hexadecim/home-voice-hub/fab/HVH-1_top_render.png

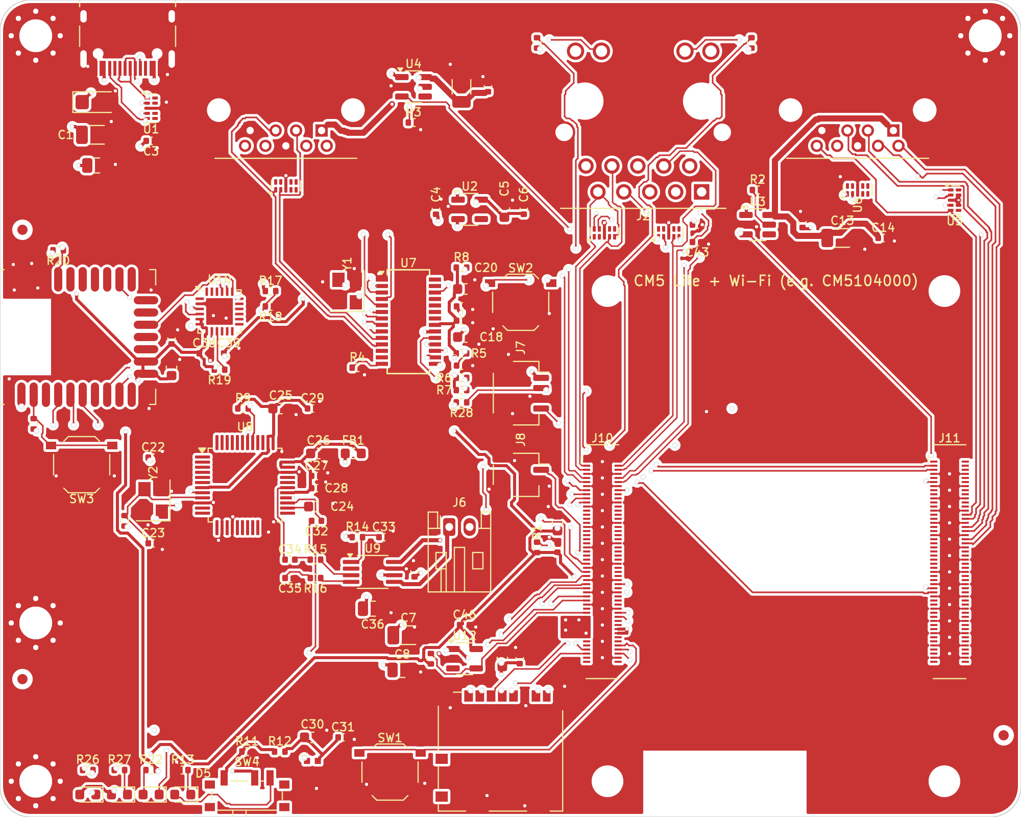
fab/HVH-1_top_render.png
