hexadecim/home-voice-hub/fab/HVH-1_BOM_full.csv

Qty | Designators | Value | Description | Manufacturer | MPN | LCSC | JLC type | LCSC stock (snapshot) | Unit price USD (LCSC, qty 1 tier) | Alternate source | Assembly | Note
1 | J1 | USB-C PWR | USB-C receptacle 16P | Korean Hroparts | TYPE-C-31-M-12 | C165948 | Extended | 367975 | 0.1872 |  | JLC SMT/THT
1 | D1 | SMF5.0A | TVS 5V unidirectional 200W SOD-123FL | LGE/various | SMF5.0A | C193402 | Extended | 557563 | 0.0305 |  | JLC SMT/THT
4 | C1 C7 C13 C15 | 47uF | Cap 47uF 6.3V X5R 1206 | Samsung | CL31A476MQHNNNE | C68361 | Extended | 803090 | 0.1655 |  | JLC SMT/THT
1 | C2 | 22uF | Cap 22uF 25V X5R 0805 | Samsung | CL21A226MAQNNNE | C45783 | Basic | 3360923 | 0.2384 |  | JLC SMT/THT
17 | C3 C6 C11 C14 C16 C19 C21 C27 C28 C29 C31 C37 C39 C41 C42 C43 C45 | 100nF | Cap 100nF 16V X7R 0402 | Samsung | CL05B104KO5NNNC | C1525 | Basic | 22560770 | 0.0043 |  | JLC SMT/THT
6 | U1 U5 U6 U13 U14 U15 | TPD4EUSB30 | 4-ch low-cap ESD (USB3/Ethernet) | Texas Instruments | TPD4EUSB30DQAR | C90627 | Extended | 23515 | 0.3787 |  | JLC SMT/THT
1 | U2 | TLV75533P | LDO 3.3V 500mA | Texas Instruments | TLV75533PDBVR | C404027 | Extended | 116994 | 0.1218 |  | JLC SMT/THT
9 | C4 C12 C17 C32 C33 C34 C35 C38 C46 | 1uF | Cap 1uF 25V X5R 0402 | Samsung | CL05A105KA5NQNC | C52923 | Basic | 7514754 | 0.0081 |  | JLC SMT/THT
5 | C5 C10 C20 C30 C44 | 4.7uF | Cap 4.7uF 16V X5R 0603 | Samsung | CL10A475KO8NNNC | C19666 | Basic | 2948420 | 0.0297 |  | JLC SMT/THT
2 | J10 J11 | DF40C-100DS | CM5 board-to-board receptacle 100P 0.4mm 1.5mm stack | Hirose | DF40C-100DS-0.4V(51) | C597931 | Extended | 29944 | 0.9688 |  | JLC SMT/THT
1 | M1 | CM5 module | Compute Module 5 - plugs into J10/J11 (not soldered) | Raspberry Pi | CM5104000 (CM5 Lite, Wireless, 4GB) |  |  |  |  | Raspberry Pi approved resellers (CM5104000 / CM5102000 / CM5108000) | customer fits CM5 module
1 | R1 | 0R | Resistor 0R 0402 | UNI-ROYAL | 0402WGF0000TCE | C17168 | Basic | 9136350 | 0.0011 |  | JLC SMT/THT
2 | C8 C36 | 10uF | Cap 10uF 25V X5R 0805 | Samsung | CL21A106KAYNNNE | C15850 | Basic | 3710191 | 0.0692 |  | JLC SMT/THT
2 | J3 J4 | USB-A | USB 3.0 Type-A receptacle, R/A THT | Amphenol | GSB311131HR | C473057 | Extended | 15128 | 1.5818 |  | JLC SMT/THT
2 | U3 U4 | TPS2553 | USB power switch, adj. ILIM | Texas Instruments | TPS2553DBVR | C55266 | Extended | 54233 | 0.5426 |  | JLC SMT/THT
2 | R2 R3 | 26k1 1% | Resistor 26.1k 1% 0402 (TPS2553 ILIM ~1.0A) | YAGEO | RC0402FR-0726K1L | C155697 | Extended | 157321 | 0.0018 |  | JLC SMT/THT
1 | U7 | FE1.1s | USB2.0 4-port MTT hub | Terminus | FE1.1S-BSOP28BCN | C9359 | Extended | 27772 | 0.6934 |  | JLC SMT/THT
2 | Y1 Y2 | 12MHz | Crystal 12MHz 20pF 3225 | Yangxing | X322512MSB4SI | C9002 | Basic | 134433 | 0.0956 |  | JLC SMT/THT
1 | R4 | 2k7 1% | Resistor 2.7k 1% 0402 | UNI-ROYAL | 0402WGF2701TCE | C25885 | Extended | 212522 | 0.0023 |  | JLC SMT/THT
11 | R5 R6 R7 R8 R11 R15 R16 R20 R21 R25 R28 | 10k | Resistor 10k 1% 0402 | UNI-ROYAL | 0402WGF1002TCE | C25744 | Basic | 21489602 | 0.0033 |  | JLC SMT/THT
5 | C18 C24 C25 C26 C40 | 10uF | Cap 10uF 10V X5R 0603 | Samsung | CL10A106KP8NNNC | C19702 | Basic | 10061272 | 0.0297 |  | JLC SMT/THT
1 | FB1 | 600R@100MHz | Ferrite bead 600R 200mA 0603 | Sunlord | GZ1608D601TF | C1002 | Basic | 717275 | 0.0116 |  | JLC SMT/THT
1 | U8 | CM108B | USB audio codec (mic in / line out) | C-Media | CM108B | C371347 | Extended | 2907 | 3.5913 |  | JLC SMT/THT
1 | R9 | 1k5 | Resistor 1.5k 1% 0402 | UNI-ROYAL | 0402WGF1501TCE | C25867 | Basic | 1809989 | 0.0029 |  | JLC SMT/THT
1 | R10 | 1M | Resistor 1M 1% 0402 | UNI-ROYAL | 0402WGF1004TCE | C26083 | Basic | 2050671 | 0.0024 |  | JLC SMT/THT
2 | C22 C23 | 27pF | Cap 27pF 50V C0G 0402 | FH | 0402CG270J500NT | C1557 | Preferred | 278621 | 0.0024 |  | JLC SMT/THT
1 | SW4 | PCM12SMTR | SPDT slide switch R/A (mic privacy) | C&K | PCM12SMTR | C221841 | Extended | 10765 | 1.272 |  | JLC SMT/THT
2 | R12 R22 | 100R | Resistor 100R 1% 0402 | UNI-ROYAL | 0402WGF1000TCE | C25076 | Basic | 8287966 | 0.0012 |  | JLC SMT/THT
1 | MK1 | ZTS6216 | Analog MEMS microphone, top port, -38dBV, 65dB SNR | ZILLTEK | ZTS6216 | C481302 | Extended | 25297 | 0.7376 |  | JLC SMT/THT
2 | D2 D5 | Red | LED red 0603 | KENTO | KT-0603R | C2286 | Basic | 7858146 | 0.0077 |  | JLC SMT/THT
3 | R13 R23 R24 | 470R | Resistor 470R 1% 0402 | UNI-ROYAL | 0402WGF4700TCE | C25117 | Basic | 646592 | 0.0027 |  | JLC SMT/THT
1 | U9 | PAM8302A | 2.5W mono class-D amplifier | Diodes Inc | PAM8302AASCR | C113367 | Extended | 13083 | 0.3221 |  | JLC SMT/THT
1 | R14 | 100k | Resistor 100k 1% 0402 | UNI-ROYAL | 0402WGF1003TCE | C25741 | Basic | 9721665 | 0.0015 |  | JLC SMT/THT
1 | J6 | SPEAKER | JST PH 2P R/A (speaker 4-8 ohm, 2W) | JST | S2B-PH-K-S(LF)(SN) | C173752 | Extended | 219392 | 0.0397 |  | JLC SMT/THT
1 | U10 | CP2102N | USB-UART bridge | Silicon Labs | CP2102N-A02-GQFN24R | C969151 | Extended | 15328 | 1.9883 |  | JLC SMT/THT
1 | R17 | 47k | Resistor 47k 1% 0402 | UNI-ROYAL | 0402WGF4702TCE | C25792 | Basic | 5135462 | 0.0026 |  | JLC SMT/THT
1 | R18 | 68k | Resistor 68k 1% 0402 | UNI-ROYAL | 0402WGF6802TCE | C36871 | Preferred | 171056 | 0.002 |  | JLC SMT/THT
3 | R19 R26 R27 | 1k | Resistor 1k 1% 0402 | UNI-ROYAL | 0402WGF1001TCE | C11702 | Basic | 14385321 | 0.0036 |  | JLC SMT/THT
1 | U11 | MGM210PA32JIA2 | Zigbee/Thread module EFR32MG21 +20dBm, chip antenna (same module as HA Yellow) | Silicon Labs | MGM210PA32JIA2 | C1864147 | Extended | 10 | 17.8482 | DigiKey 336-MGM210PA32JIA2-ND / Farnell 3463094 (R variant) | JLC SMT/THT | Low LCSC stock: order via JLC Global Sourcing or consign from DigiKey
1 | D4 | Blue | LED blue 0603 | XINGLIGHT | XL-1608UBC-04 | C965807 | Extended | 1818138 | 0.0043 |  | JLC SMT/THT
3 | SW1 SW2 SW3 | TS-1187A | Tactile switch 5.1x5.1mm SMD | XKB | TS-1187A-B-A-B | C318884 | Basic | 296384 | 0.0207 |  | JLC SMT/THT
13 | TP1 TP2 TP3 TP4 TP5 TP6 TP7 TP8 TP9 TP10 TP11 TP12 TP13 | TP | Test pad |  |  |  |  |  |  |  | not assembled
1 | J2 | RJ45 1G | RJ45 gigabit MagJack with LEDs | HanRun | HR911130A | C54408 | Extended | 21057 | 2.5488 |  | JLC SMT/THT
1 | J5 | microSD | microSD push-pull socket | Molex | 1040310811 | C585350 | Extended | 4106 | 0.8327 |  | JLC SMT/THT
1 | U12 | RT9742GGJ5 | SD card power switch | Richtek | RT9742GGJ5 | C250547 | Extended | 11605 | 0.176 |  | JLC SMT/THT
1 | D3 | Green | LED green 0603 | XINGLIGHT | XL-1608UGC-04 | C965804 | Extended | 2090501 | 0.005 |  | JLC SMT/THT
1 | J7 | FAN | JST SH 4P R/A (Pi fan) | JST | SM04B-SRSS-TB(LF)(SN) | C160404 | Extended | 60891 | 0.2151 |  | JLC SMT/THT
1 | J8 | RTC BAT | JST SH 2P R/A (Pi RTC battery) | JST | SM02B-SRSS-TB(LF)(SN) | C160402 | Extended | 63871 | 0.1327 |  | JLC SMT/THT
4 | H1 H2 H3 H4 | M3 | Mounting hole M3, GND |  |  |  |  |  |  |  | not assembled
3 | FID1 FID2 FID3 | FID | Fiducial |  |  |  |  |  |  |  | not assembled
