hexadecim/home-voice-hub/enclosure/hvh1_enclosure_assembly.step

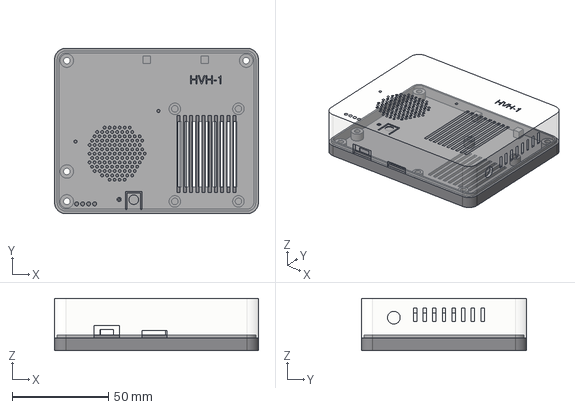
[picture p2: CAD file, 2026-11-11]
enclosure/hvh1_enclosure_assembly.step
105.8 x 85.8 x 27.1 mm
base
lid
