hexadecim/home-voice-hub/fab/HVH-1_pcb.step

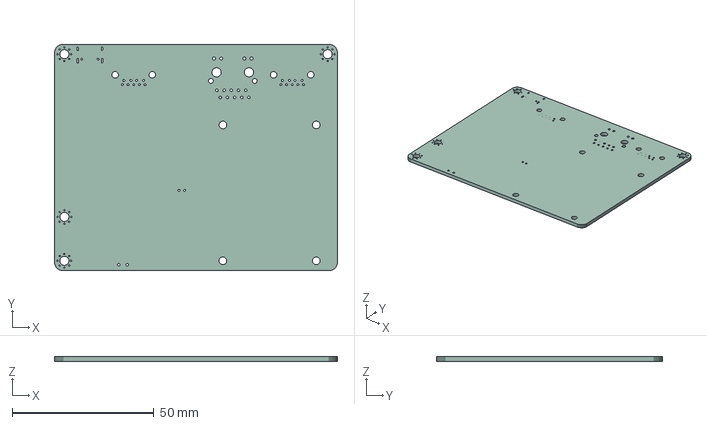
[picture p3: CAD file, 2026-11-11]
fab/HVH-1_pcb.step
100.0 x 80.0 x 1.60 mm
