hexadecim/home-voice-hub/enclosure/hvh1_lid.step

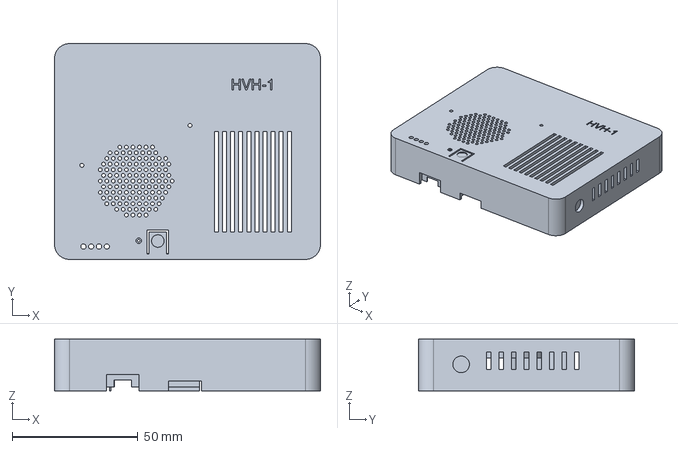
[picture p4: CAD file, 2026-11-11]
enclosure/hvh1_lid.step
105.8 x 85.8 x 20.5 mm
