hexadecim/home-voice-hub/enclosure/hvh1_base.step

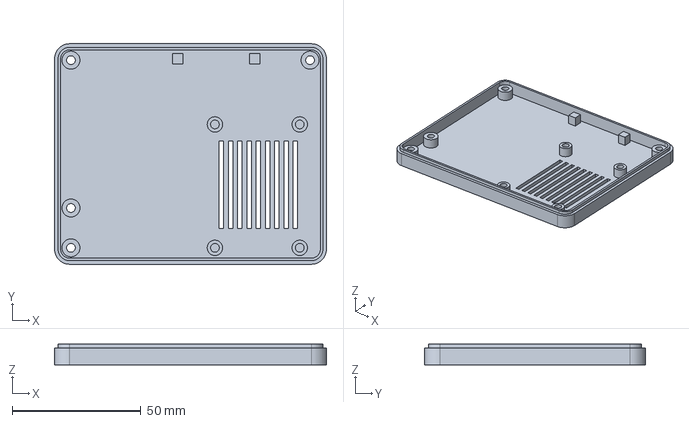
[picture p5: CAD file, 2026-11-11]
enclosure/hvh1_base.step
105.8 x 85.8 x 8.10 mm
