hexadecim/home-voice-hub/(list of files, cad)

Other CAD files:
enclosure/hvh1_base.3mf
enclosure/hvh1_base.stl
enclosure/hvh1_lid.3mf
enclosure/hvh1_lid.stl
