hexadecim/home-voice-hub/fab/HVH-1_schematic.pdf

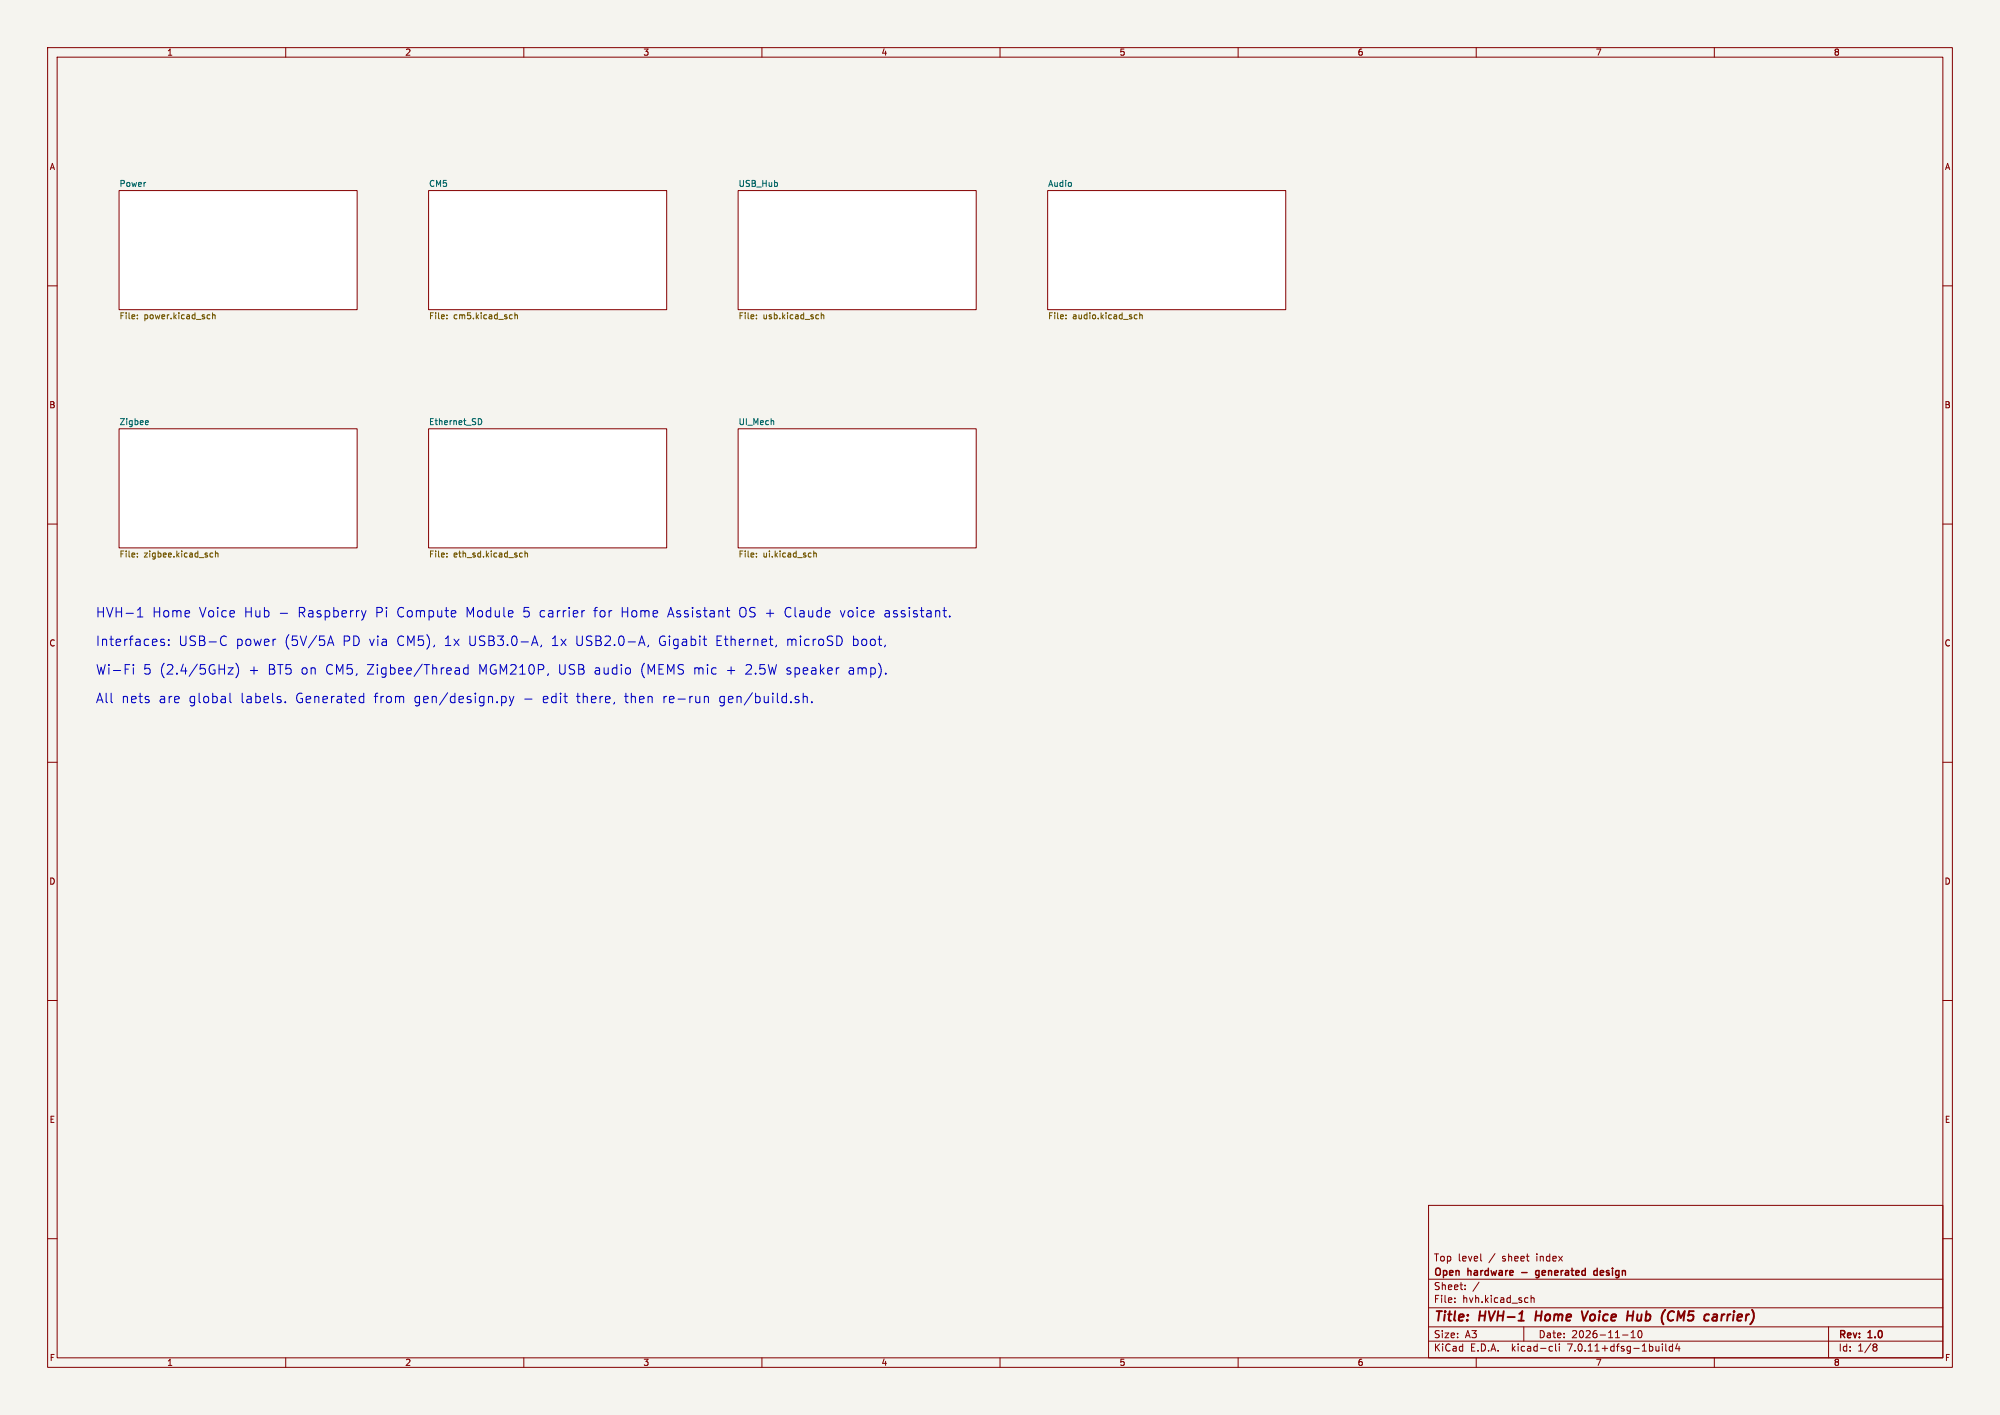
[picture p6: page 1]

Top level / sheet index

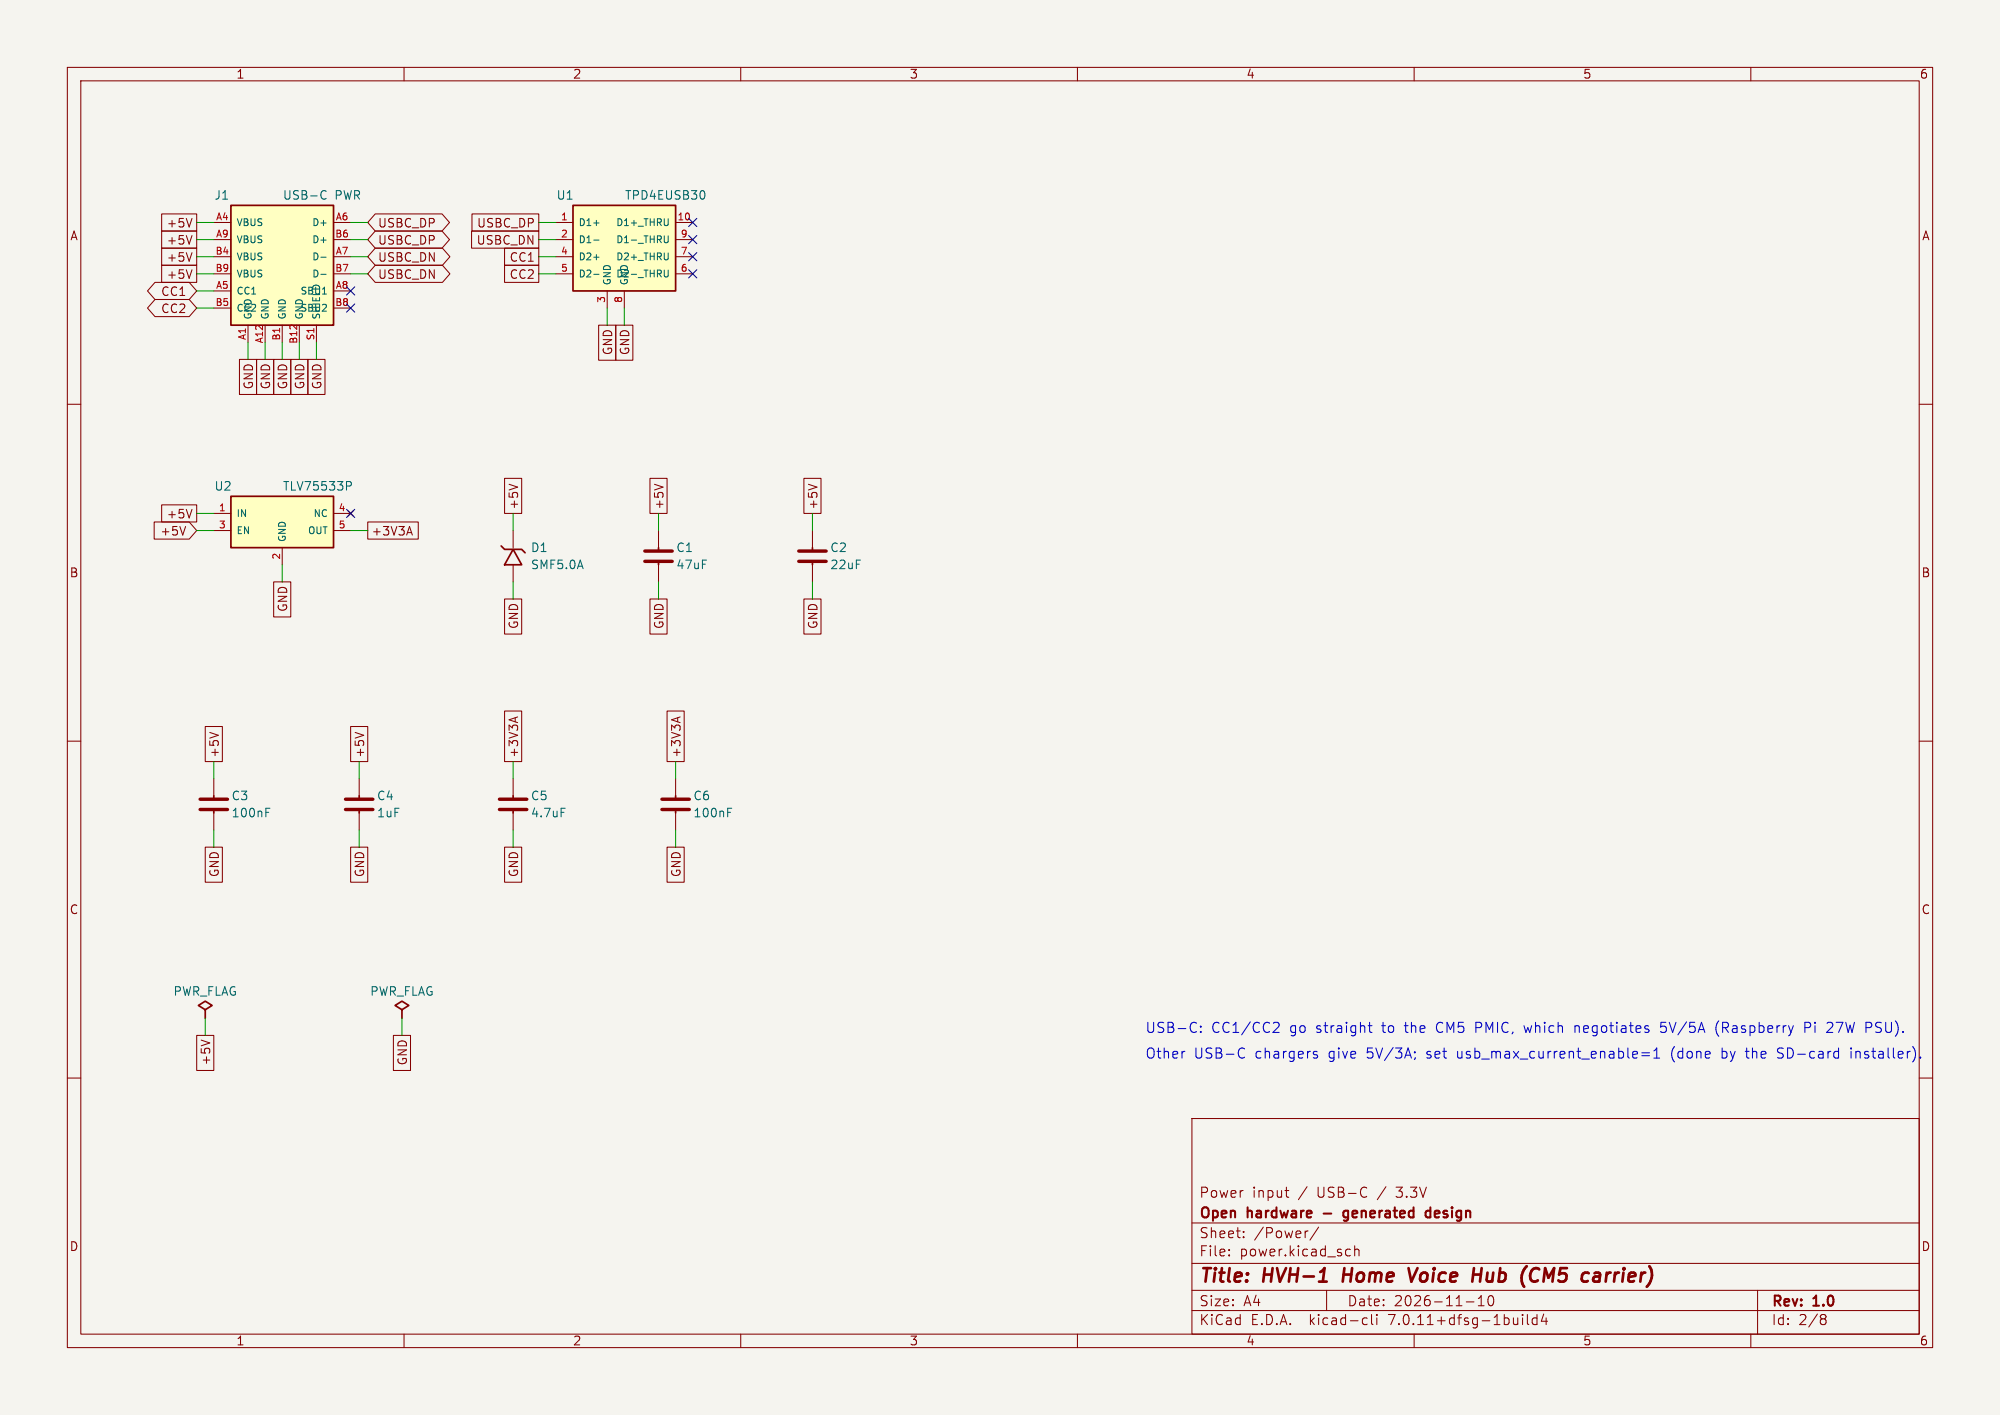
[picture p7: page 2]

8 D1-_THRU 9 U1 TPD4EUSB30 GND A1 GND A12 VBUS A4 CC1 A5 D+ A6 D- A7 SBU1 A8 VBUS A9 GND B1 GND B12 VBUS B4 CC2 B5 D+ B6 D- B7 SBU2 B8 VBUS B9 SHIELD S1 J1 USB-C PWR

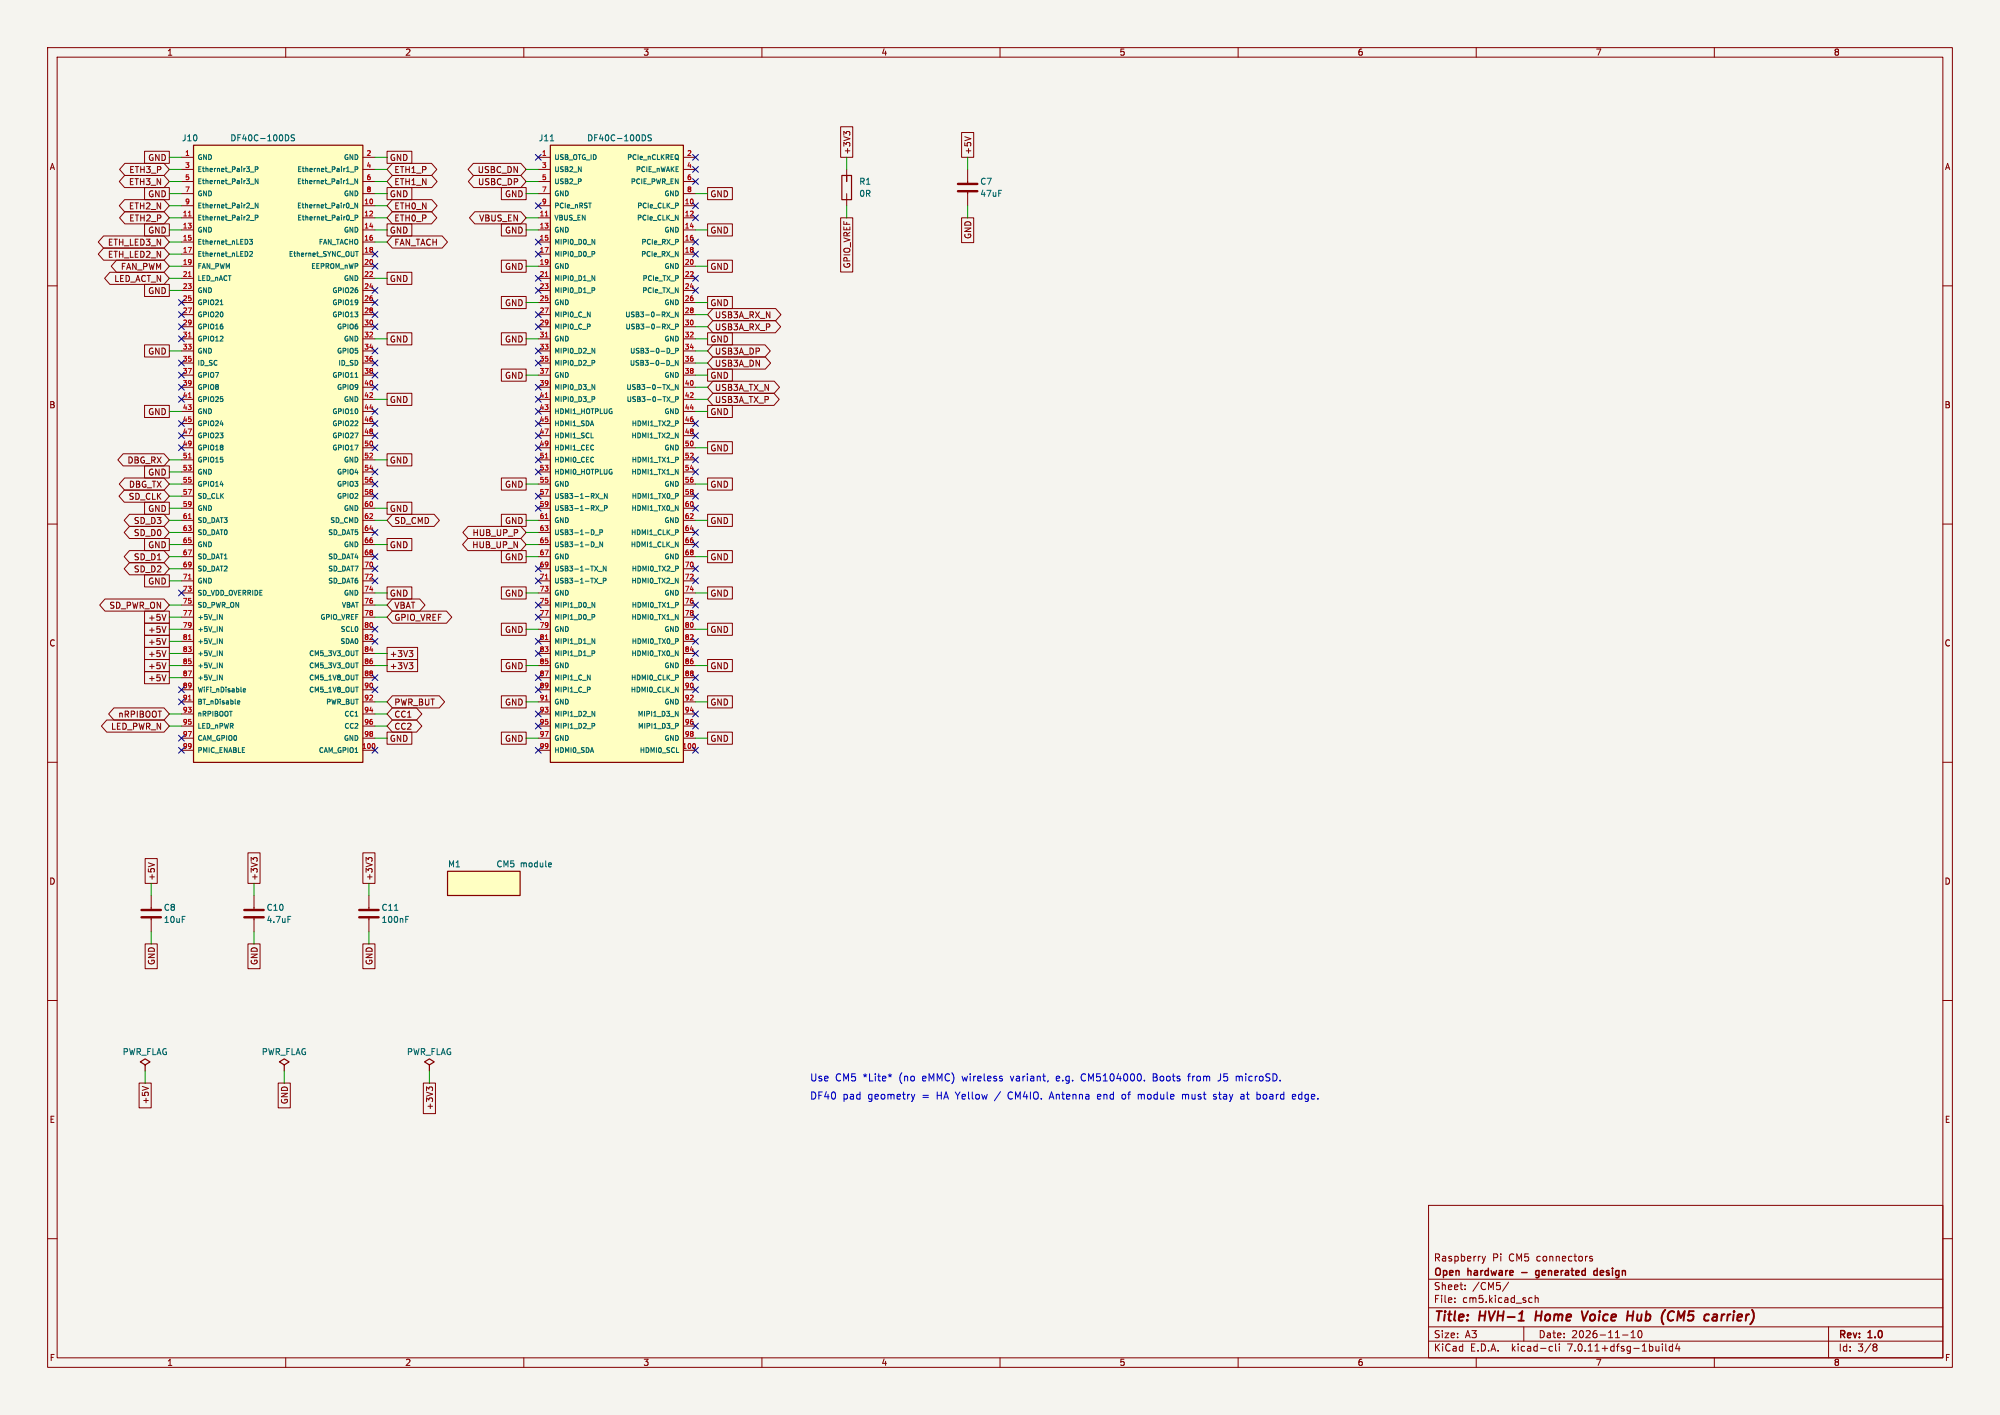
[picture p8: page 3]

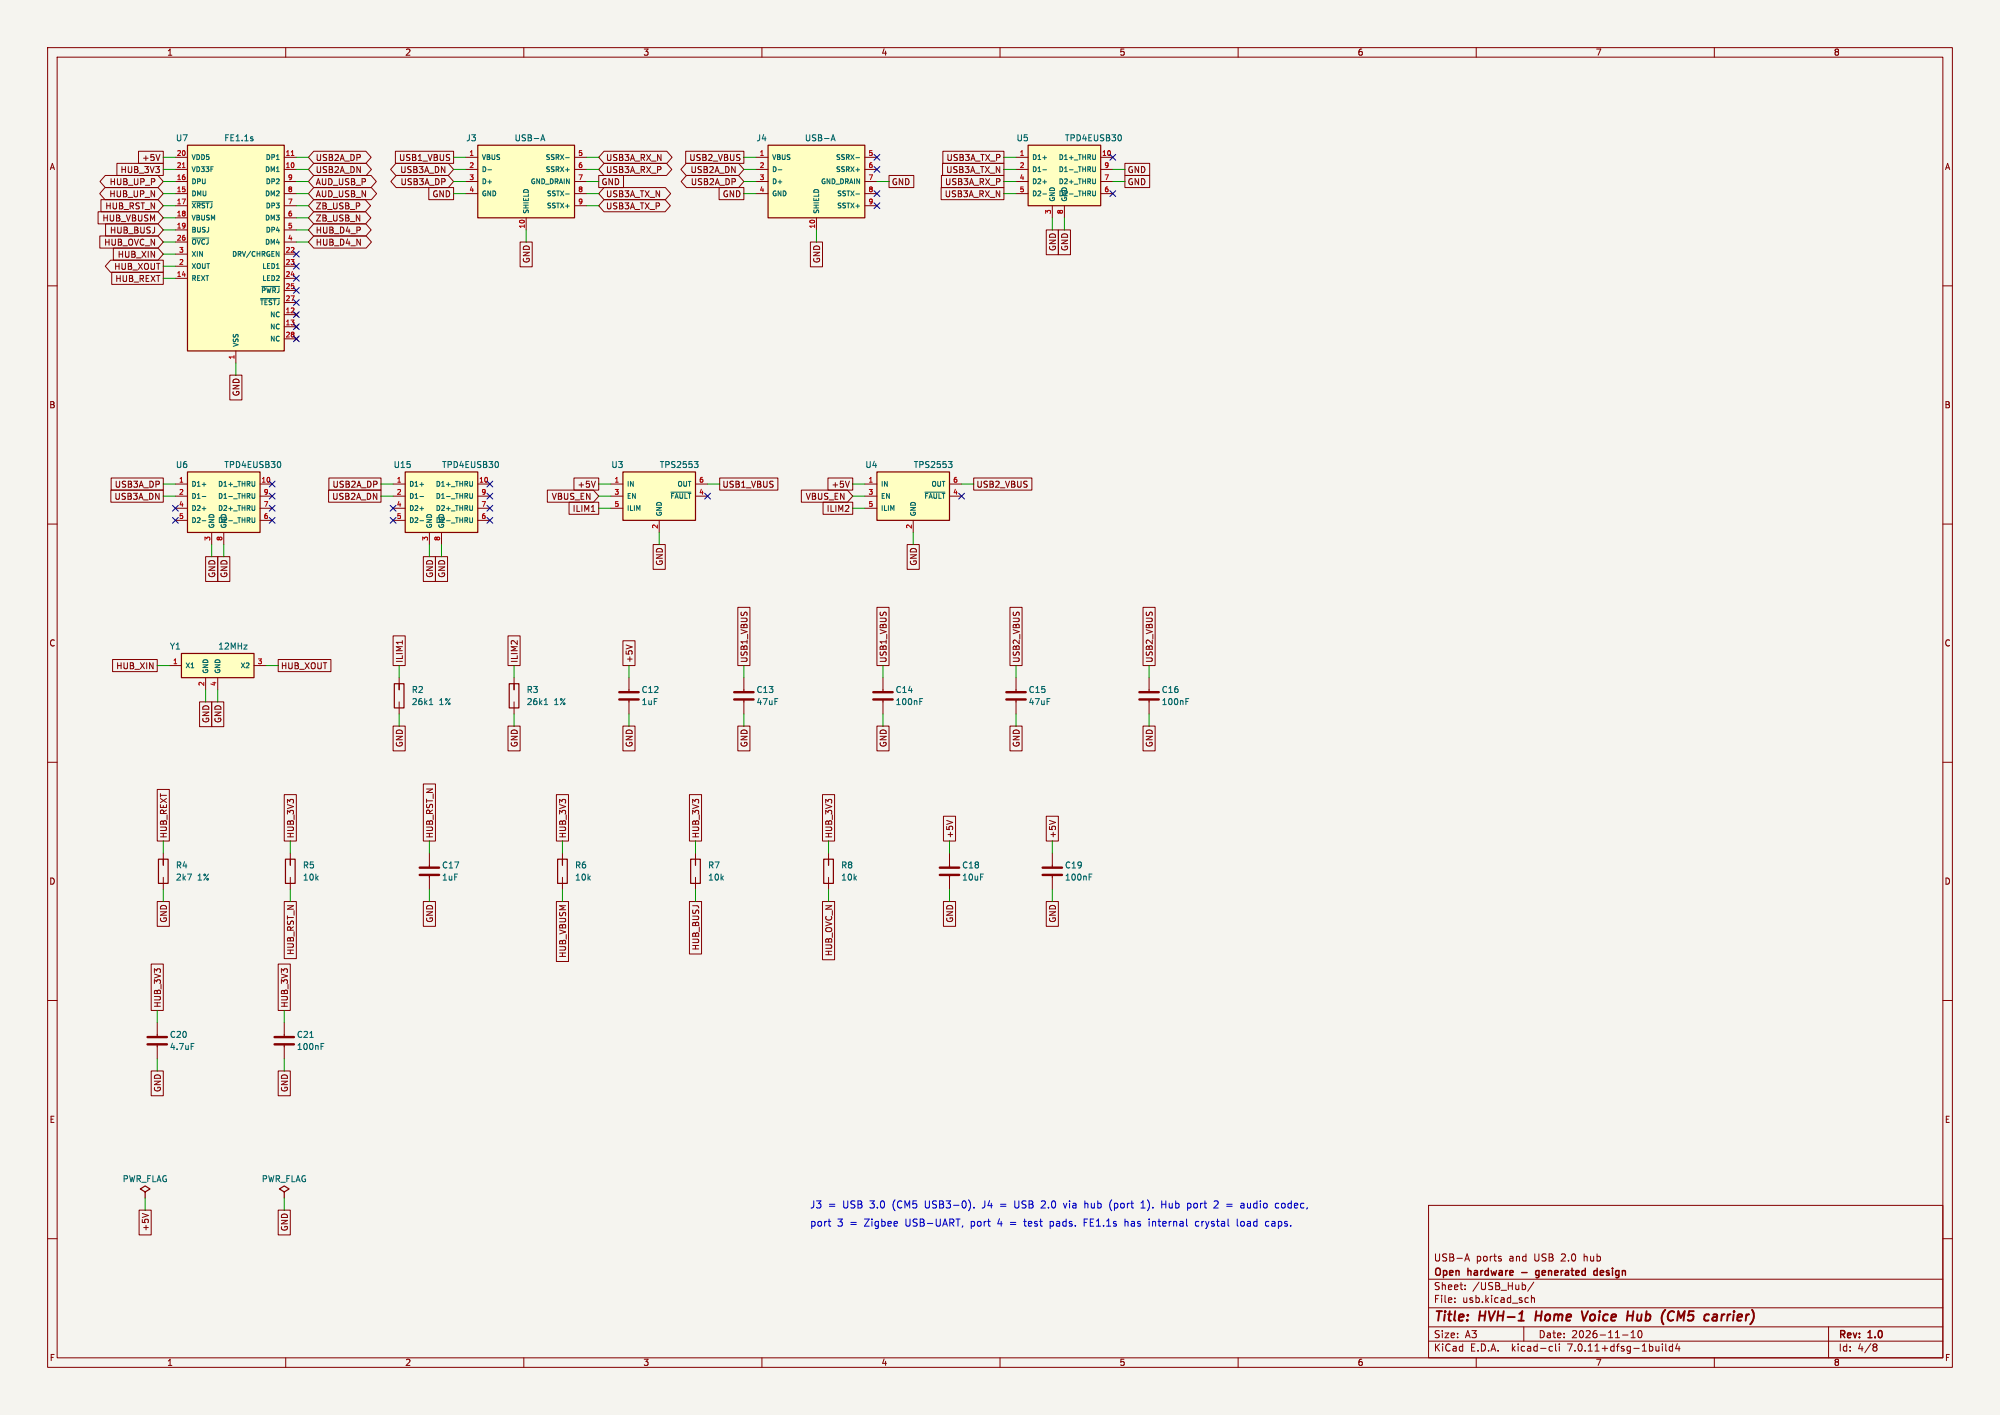
[picture p9: page 4]

1 DM1 10 DP1 11 NC 12 NC 13 REXT 14 DMU 15 DPU 16 ~{XRSTJ} 17 VBUSM 18 BUSJ 19 XOUT 2 VDD5 20 VD33F 21 DRV/CHRGEN 22

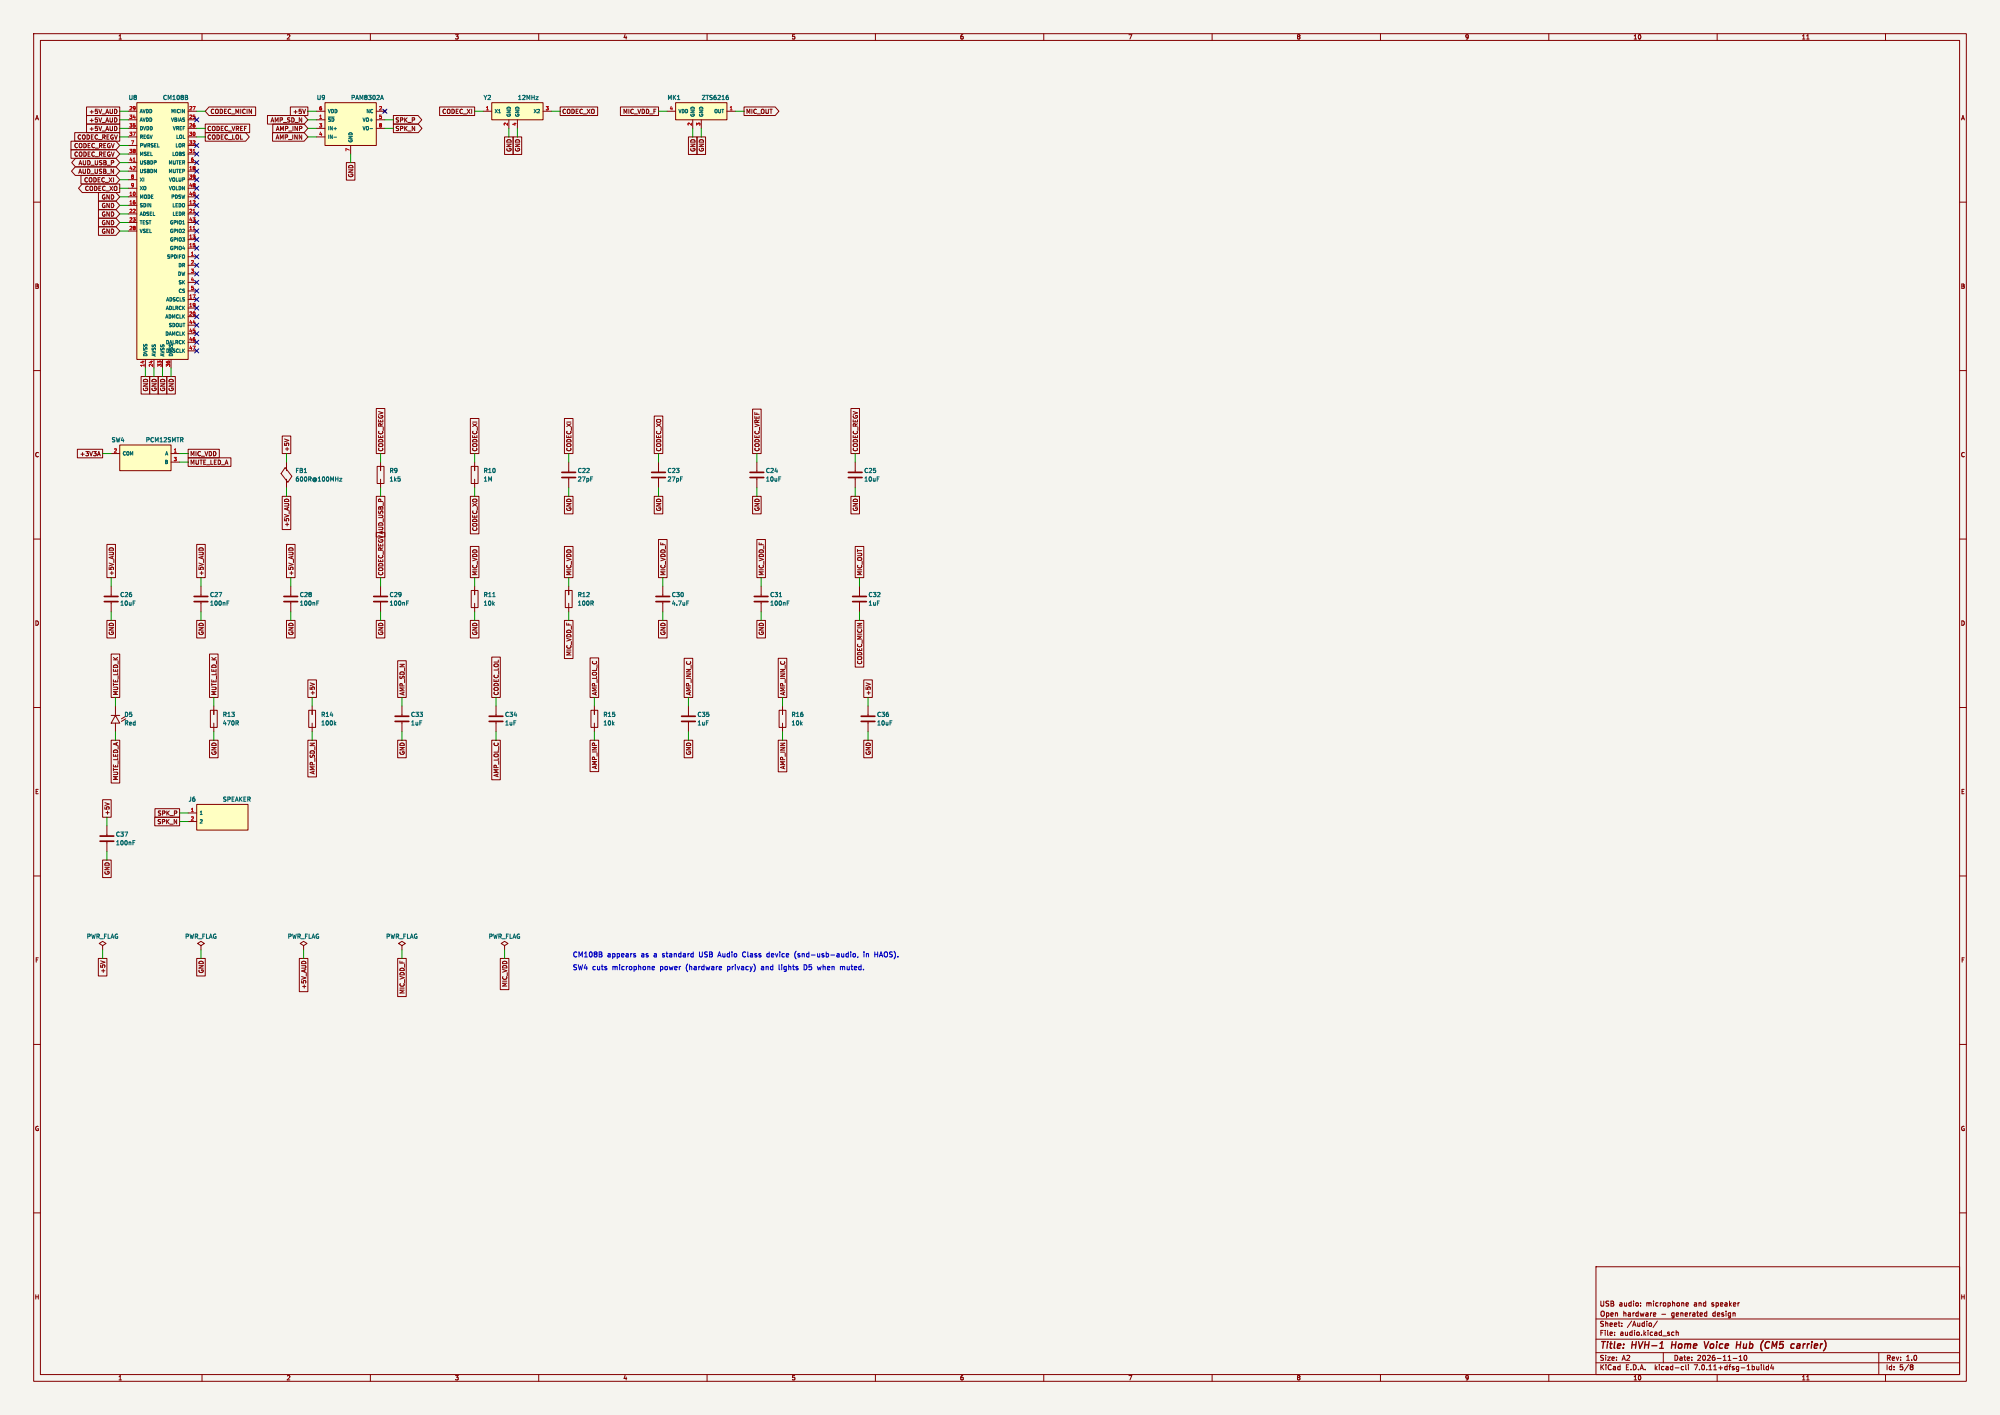
[picture p10: page 5]

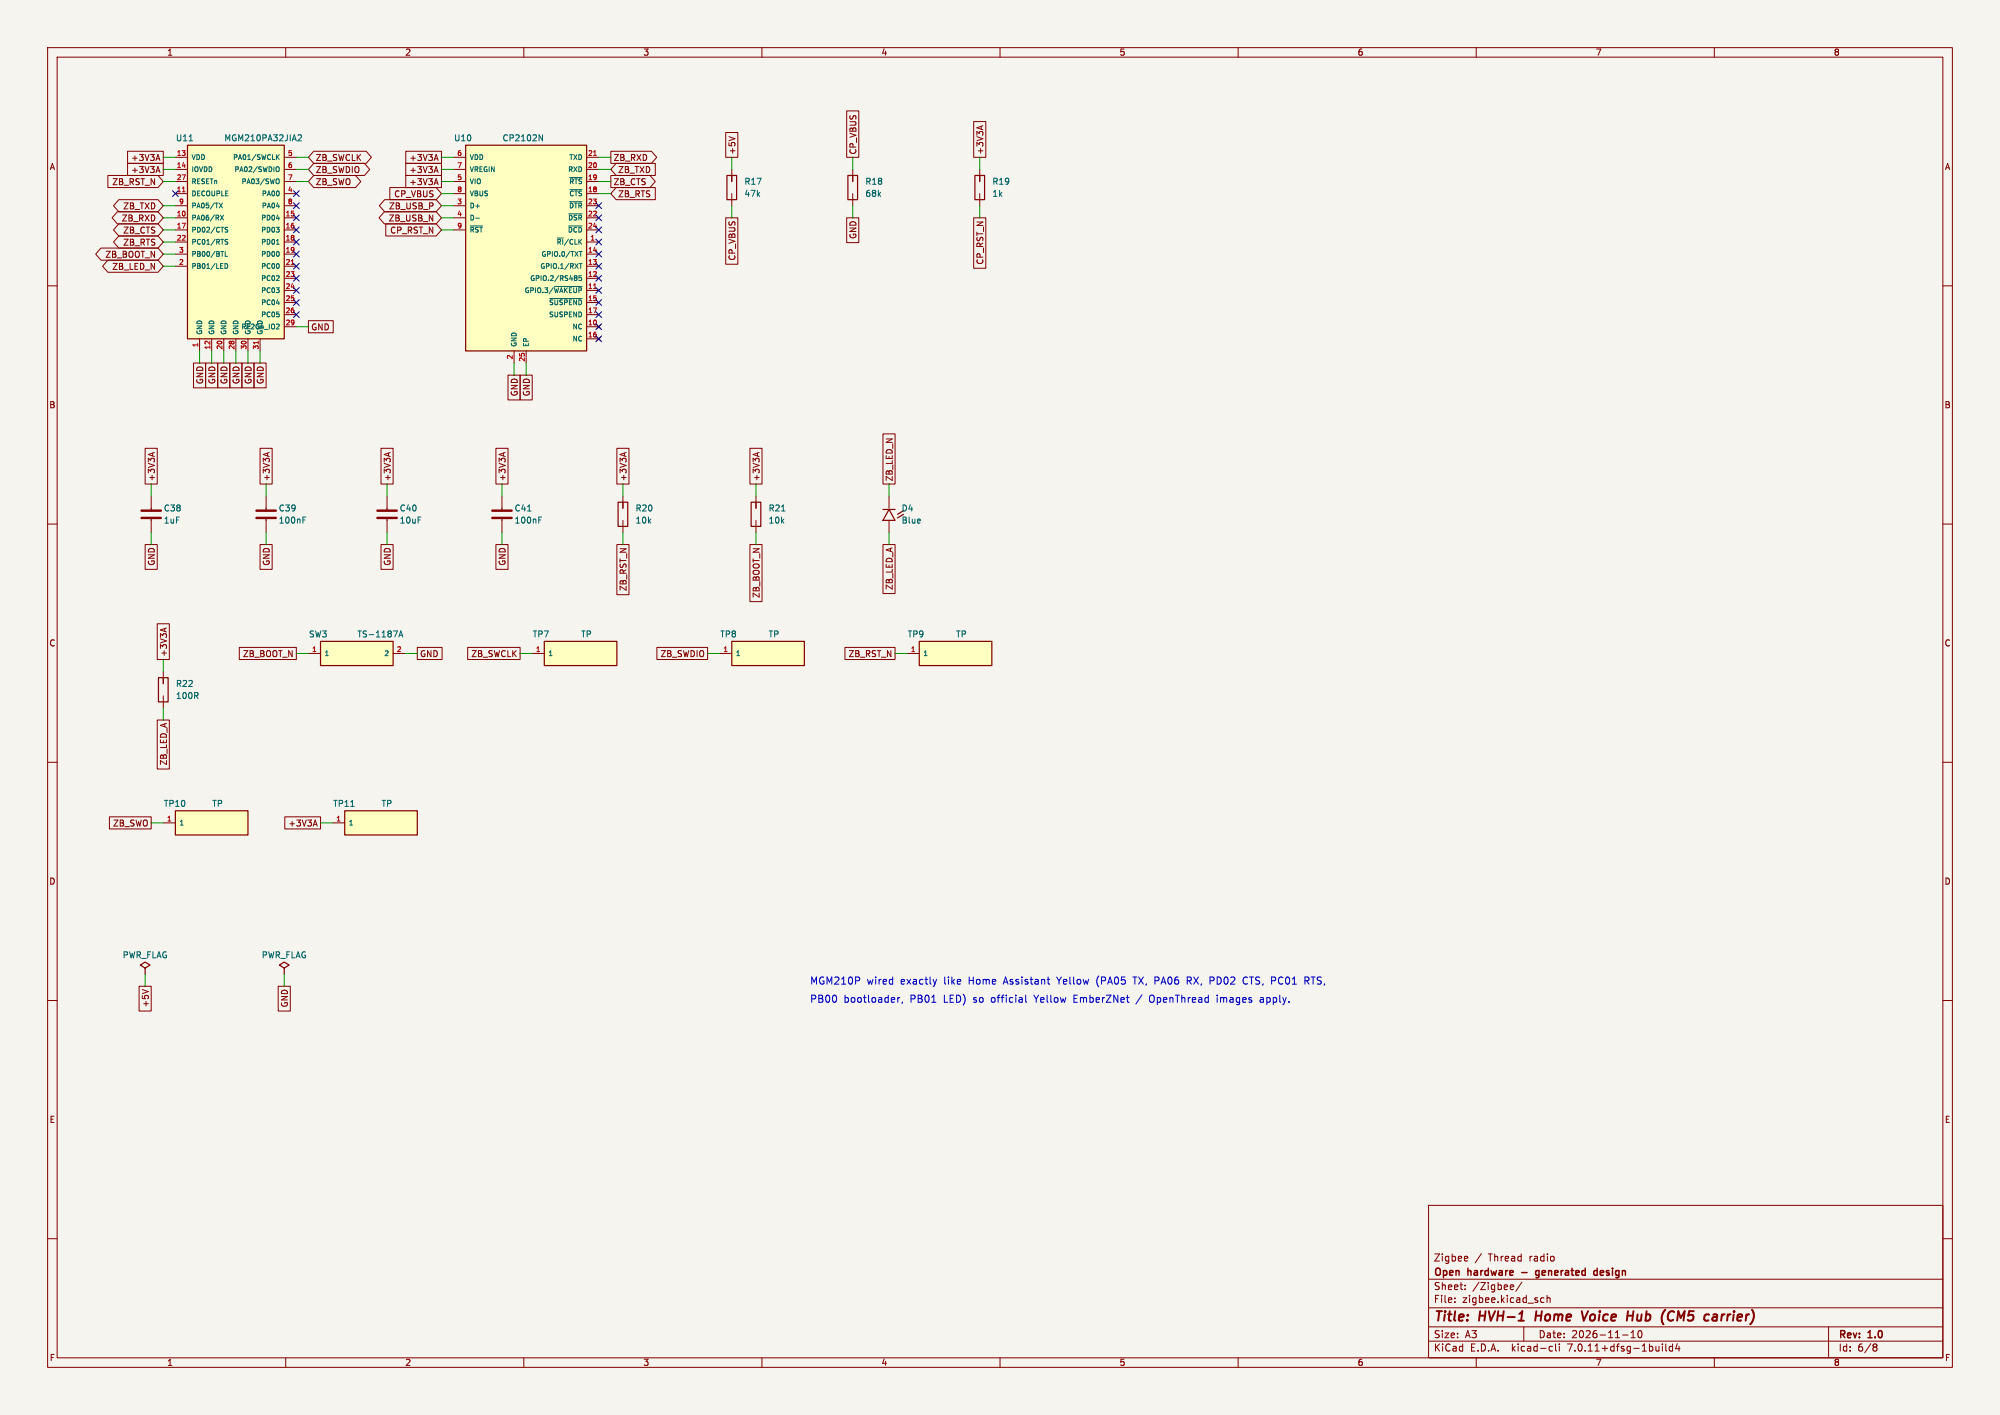
[picture p11: page 6]

2 RXD 20 TXD 21 ~{DSR}22 ~{DTR}23 ~{DCD}24 EP 25 D+ 3 D- 4 VIO 5 VDD 6 VREGIN 7 VBUS 8 ~{RST} 9U10 CP2102N

1 PA06/RX 10 DECOUPLE 11 GND 12 VDD 13

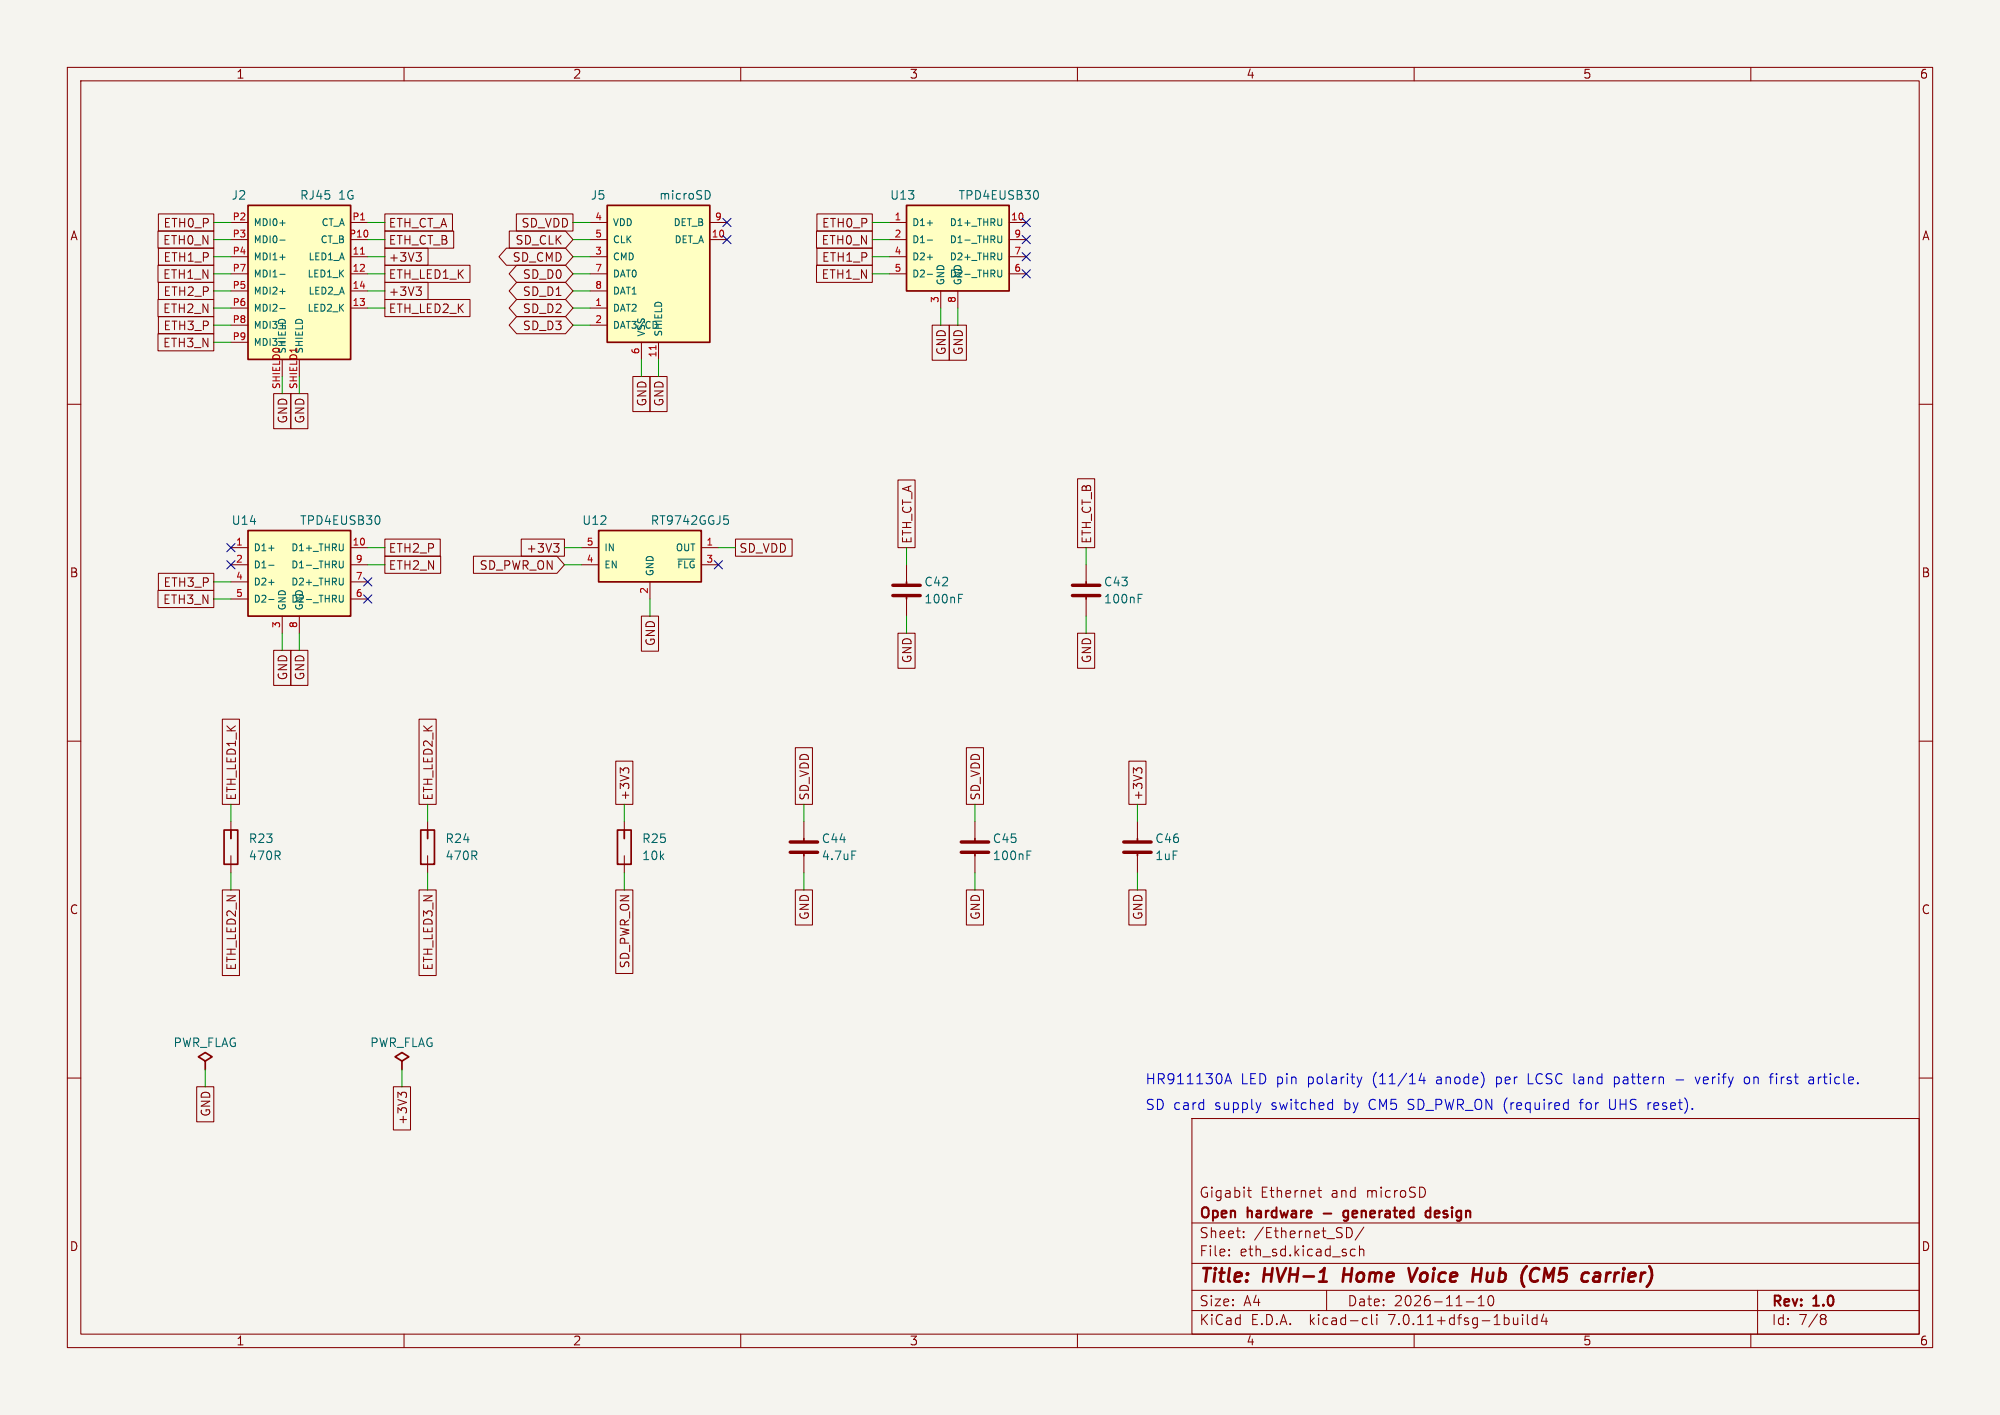
[picture p12: page 7]

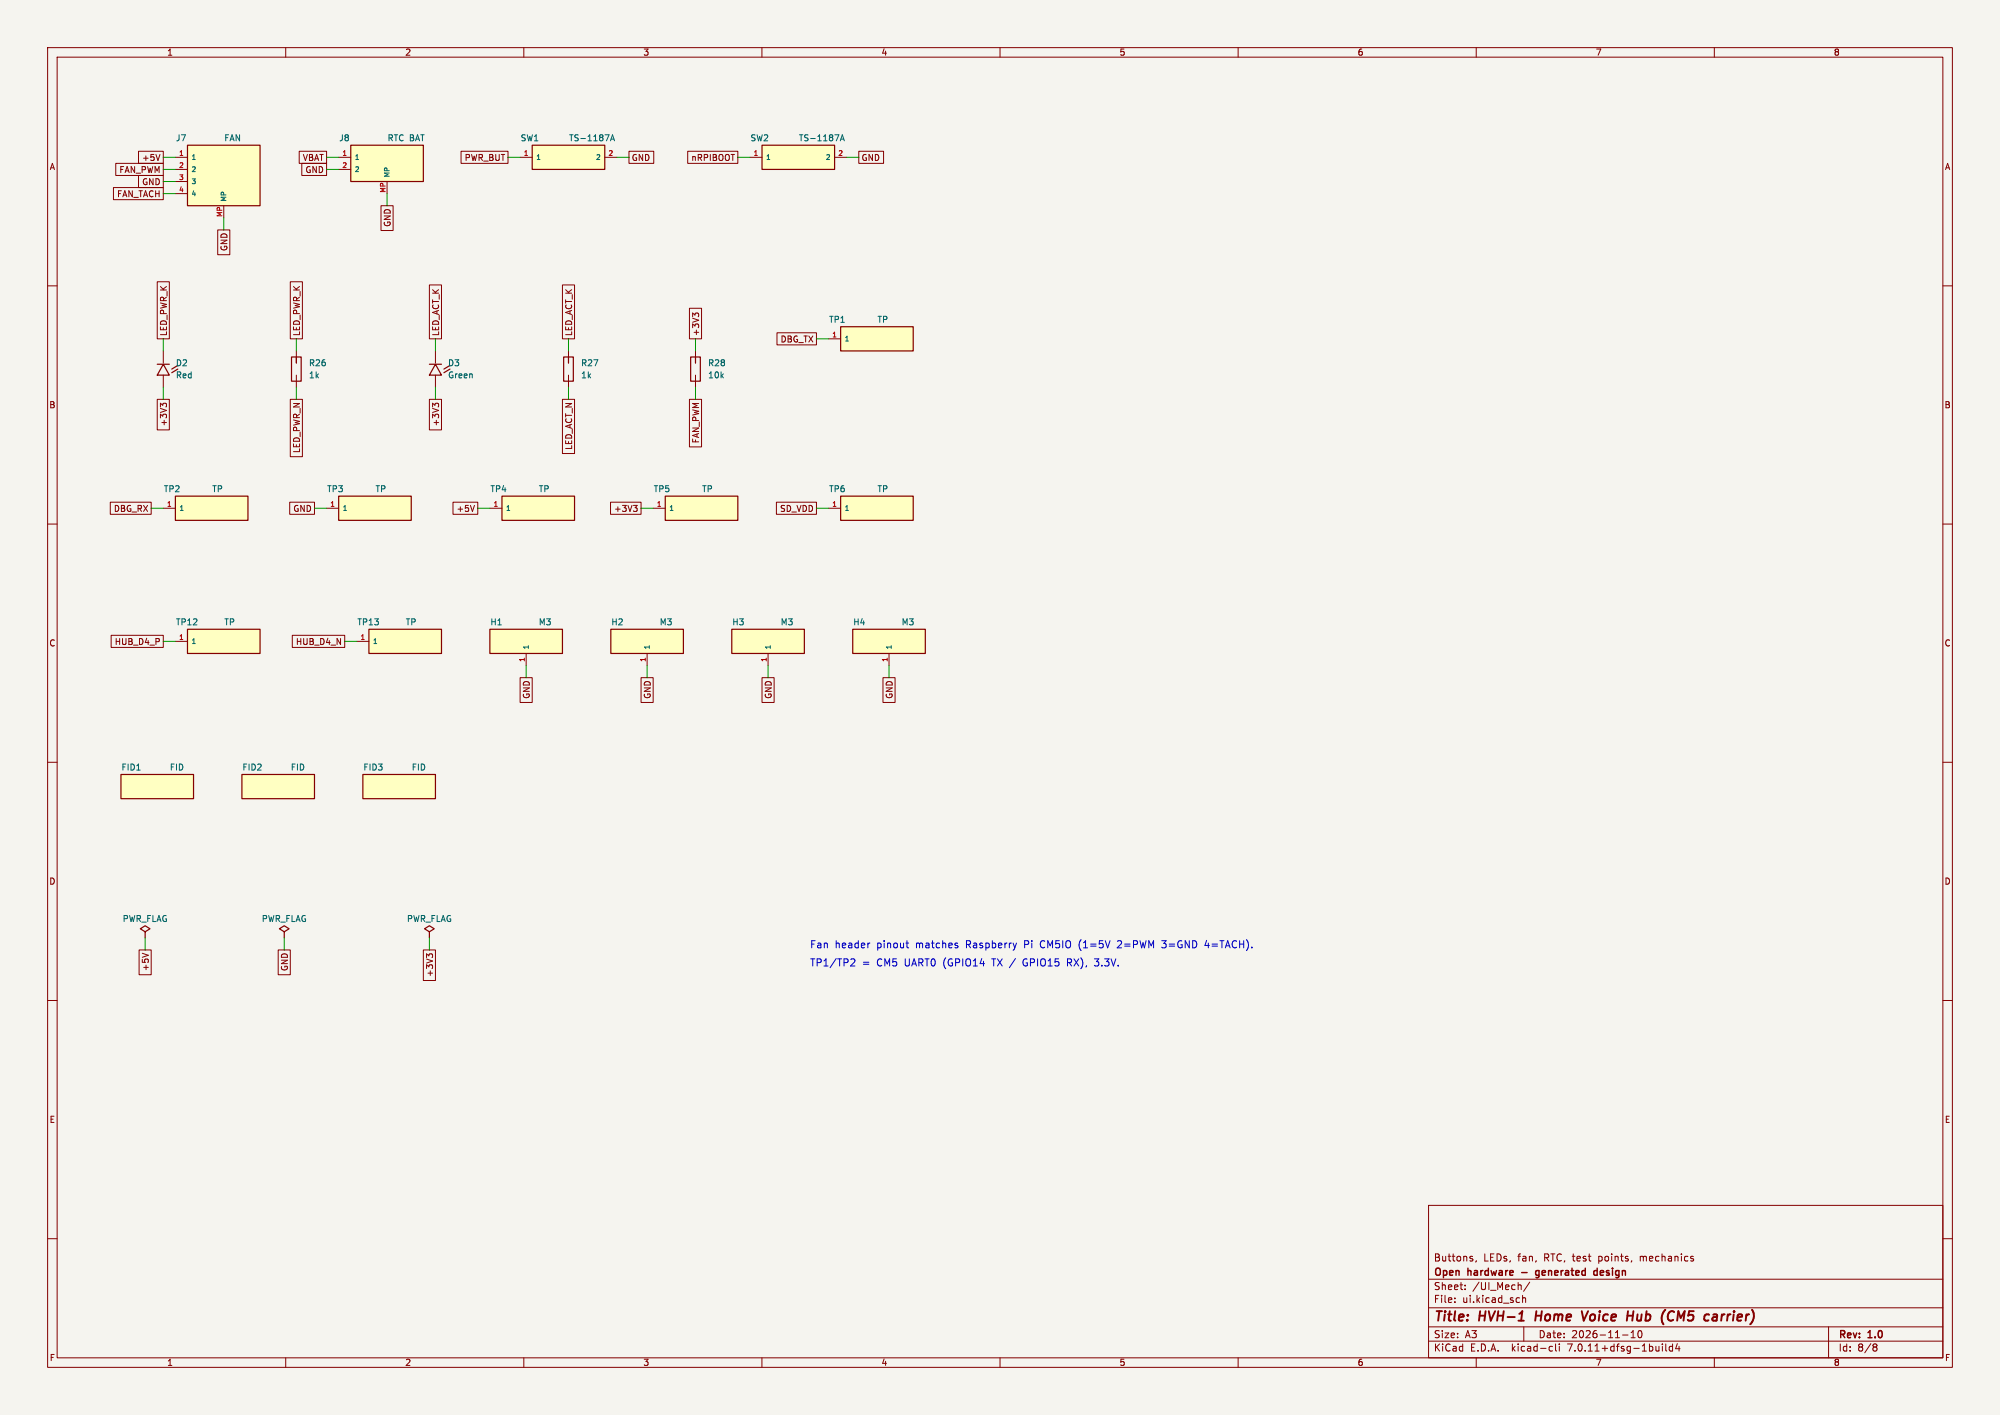
[picture p13: page 8]
