hexadecim/home-voice-hub/fab/HVH-1_assembly_bottom.pdf

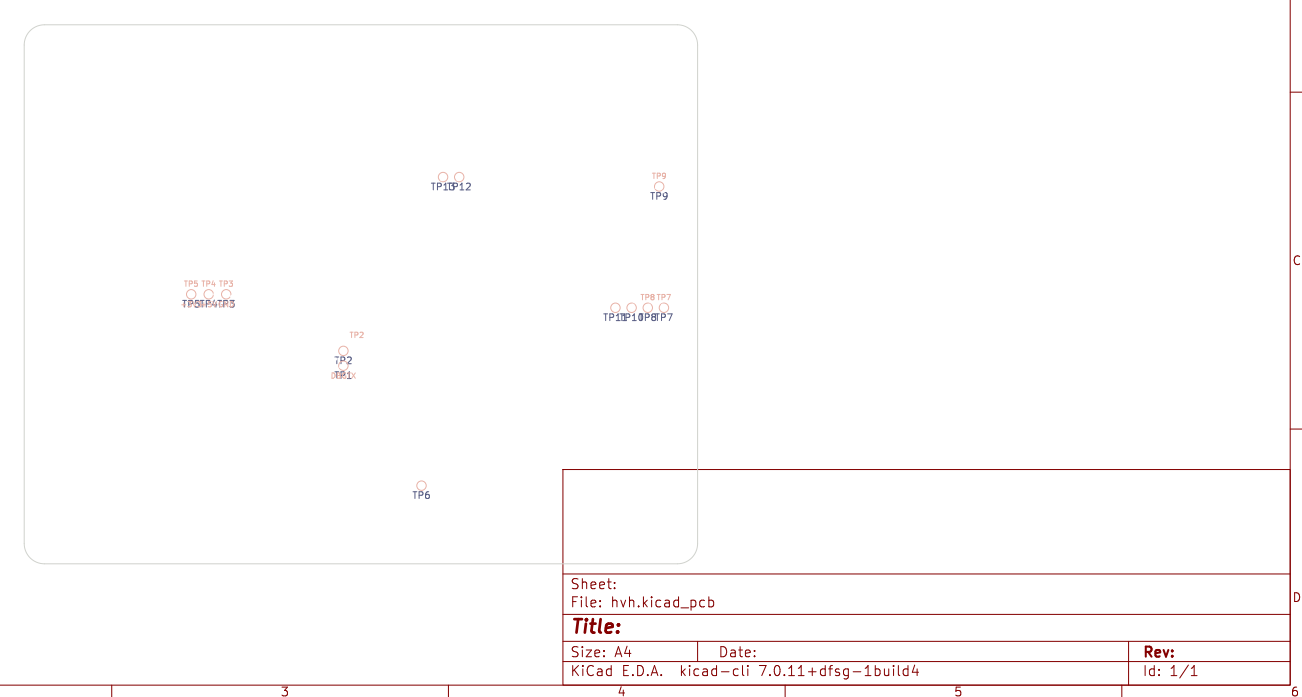
[picture p14: page 1]
