hexadecim/home-voice-hub/fab/HVH-1_assembly_top.pdf

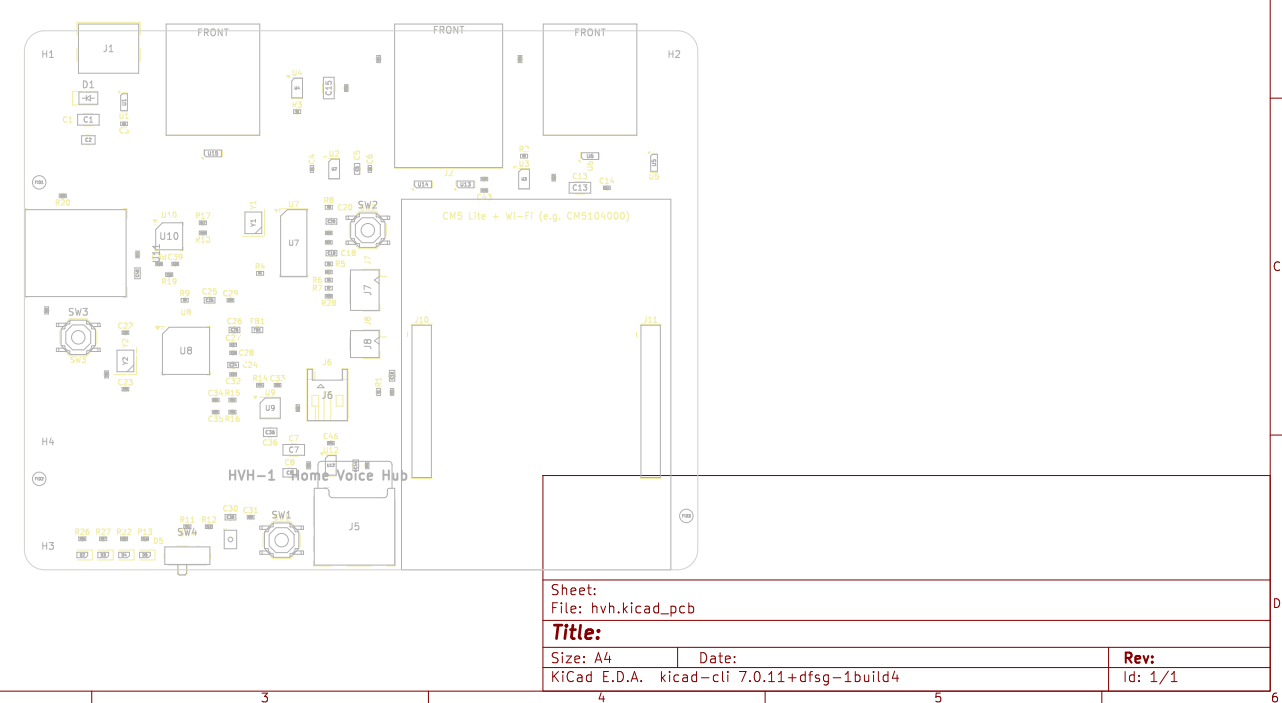
[picture p15: page 1]
