hexadecim/home-voice-hub/kicad/hvh.kicad_pcb

## KiCad design kicad/hvh.kicad_pcb (2026-11-11)

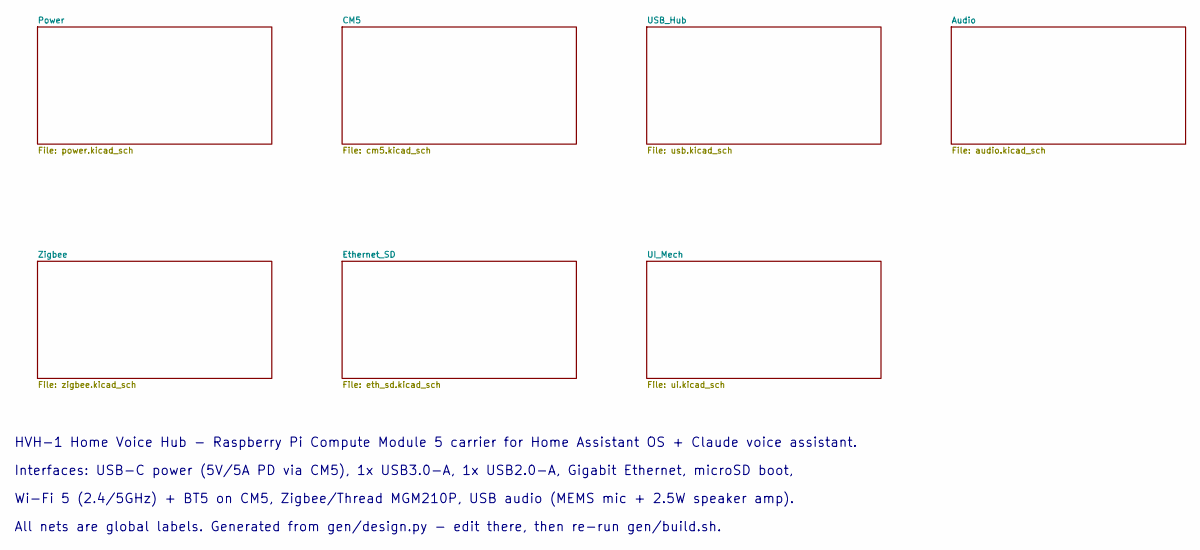
[picture p16: schematic hvh.kicad_sch, HVH-1 Home Voice Hub (CM5 carrier)]

Notes on the sheet:
HVH-1 Home Voice Hub - Raspberry Pi Compute Module 5 carrier for Home Assistant OS + Claude voice assistant.
Interfaces: USB-C power (5V/5A PD via CM5), 1x USB3.0-A, 1x USB2.0-A, Gigabit Ethernet, microSD boot,
Wi-Fi 5 (2.4/5GHz) + BT5 on CM5, Zigbee/Thread MGM210P, USB audio (MEMS mic + 2.5W speaker amp).
All nets are global labels. Generated from gen/design.py - edit there, then re-run gen/build.sh.

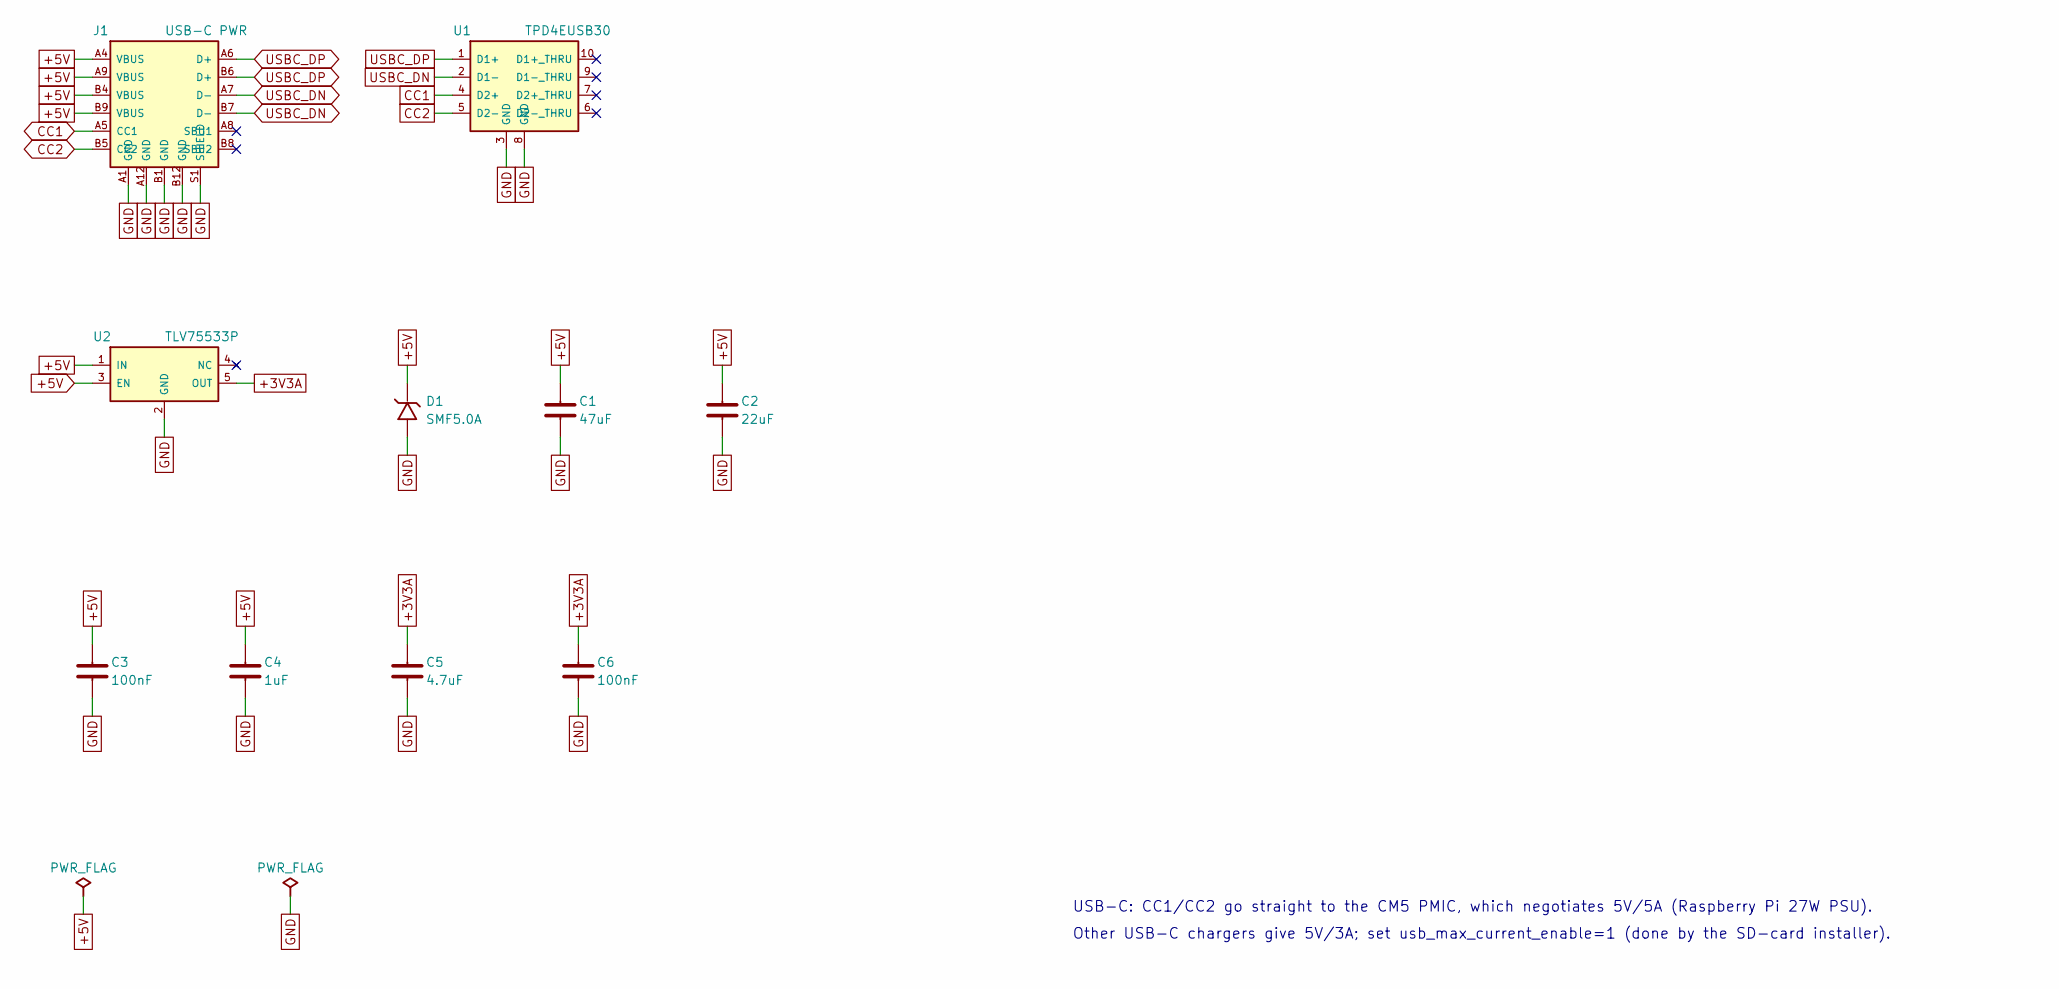
[picture p17: schematic power.kicad_sch, HVH-1 Home Voice Hub (CM5 carrier)]

Parts:
C1: 47uF; C_1206_3216Metric; MPN CL31A476MQHNNNE; LCSC C68361
C2: 22uF; C_0805_2012Metric; MPN CL21A226MAQNNNE; LCSC C45783
C3, C6: 100nF; C_0402_1005Metric; MPN CL05B104KO5NNNC; LCSC C1525
C4: 1uF; C_0402_1005Metric; MPN CL05A105KA5NQNC; LCSC C52923
C5: 4.7uF; C_0603_1608Metric; MPN CL10A475KO8NNNC; LCSC C19666
D1: SMF5.0A; D_SMF; MPN SMF5.0A; LCSC C193402
J1: USB-C PWR; USB_C_Receptacle_HRO_TYPE-C-31-M-12; MPN TYPE-C-31-M-12; LCSC C165948
U1: TPD4EUSB30; USON-10_2.5x1.0mm_P0.5mm; MPN TPD4EUSB30DQAR; LCSC C90627
U2: TLV75533P; SOT-23-5; MPN TLV75533PDBVR; LCSC C404027

Connections:
+3V3A: C5.1, C6.1, U2.5 (OUT); also elsewhere on the board
+5V: C1.1, C2.1, C3.1, C4.1, D1.1, J1.A4 (VBUS), J1.A9 (VBUS), J1.B4 (VBUS), J1.B9 (VBUS), U2.1 (IN), U2.3 (EN); also elsewhere on the board
CC1: J1.A5 (CC1), U1.4 (D2+); also elsewhere on the board
CC2: J1.B5 (CC2), U1.5 (D2-); also elsewhere on the board
GND: C1.2, C2.2, C3.2, C4.2, C5.2, C6.2, D1.2, J1.A1 (GND), J1.A12 (GND), J1.B1 (GND), J1.B12 (GND), J1.S1 (SHIELD), U1.3 (GND), U1.8 (GND), U2.2 (GND); also elsewhere on the board
USBC_DN: J1.A7 (D-), J1.B7 (D-), U1.2 (D1-); also elsewhere on the board
USBC_DP: J1.A6 (D+), J1.B6 (D+), U1.1 (D1+); also elsewhere on the board

Notes on the sheet:
USB-C: CC1/CC2 go straight to the CM5 PMIC, which negotiates 5V/5A (Raspberry Pi 27W PSU).
Other USB-C chargers give 5V/3A; set usb_max_current_enable=1 (done by the SD-card installer).

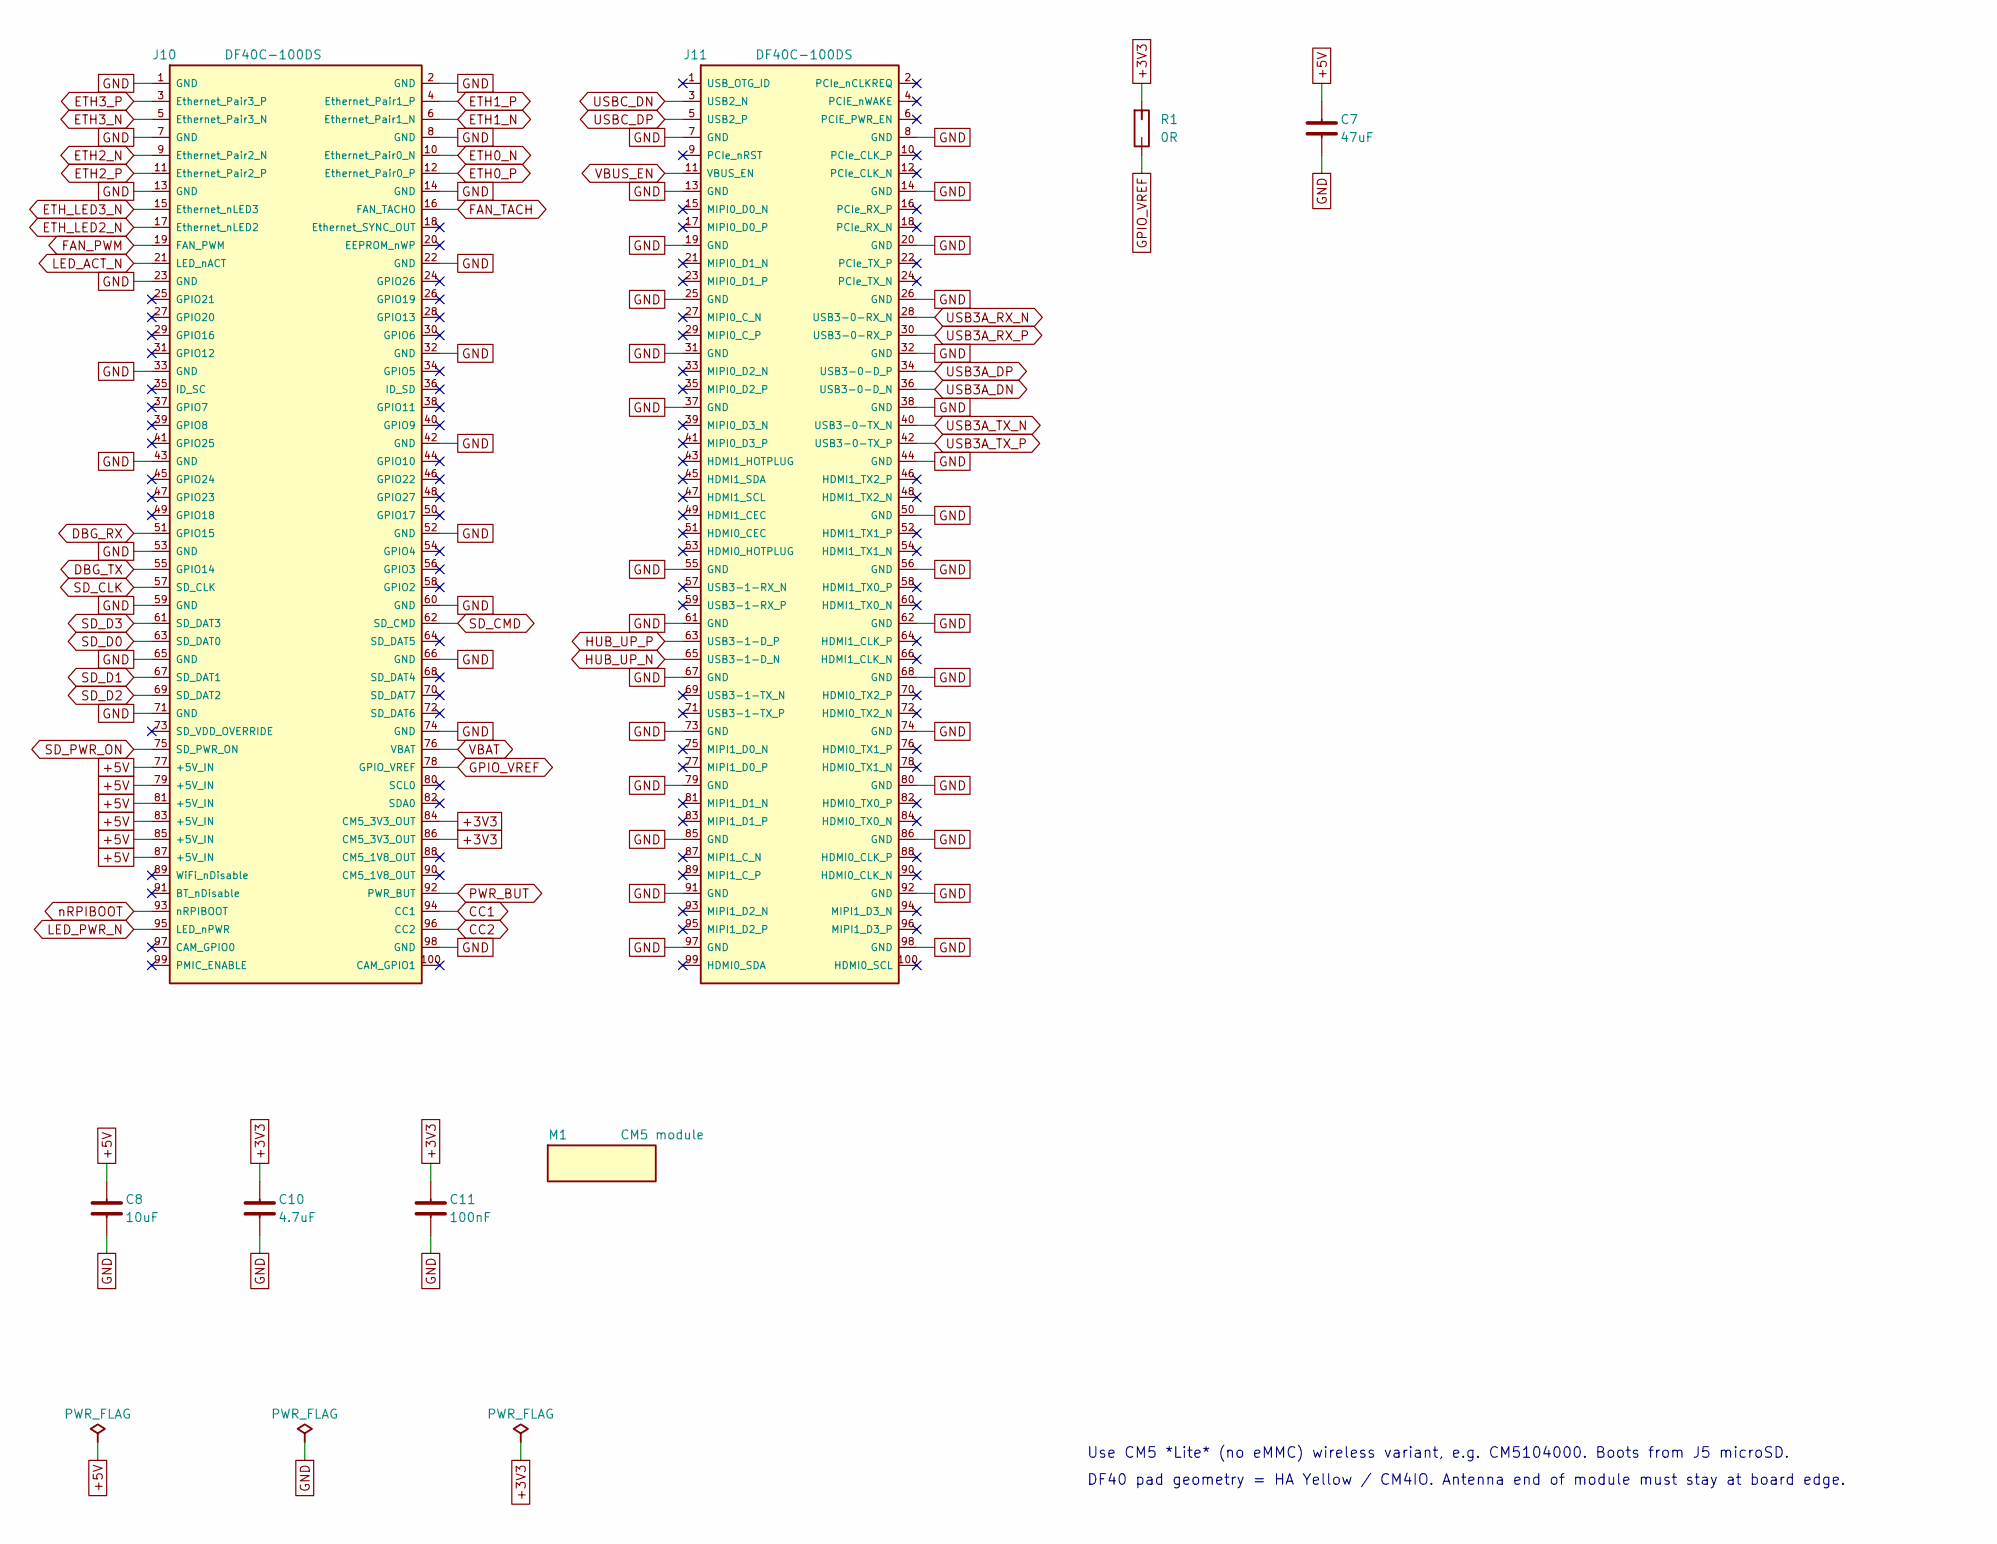
[picture p18: schematic cm5.kicad_sch, HVH-1 Home Voice Hub (CM5 carrier)]

Parts:
C7: 47uF; C_1206_3216Metric; MPN CL31A476MQHNNNE; LCSC C68361
C8: 10uF; C_0805_2012Metric; MPN CL21A106KAYNNNE; LCSC C15850
C10: 4.7uF; C_0603_1608Metric; MPN CL10A475KO8NNNC; LCSC C19666
C11: 100nF; C_0402_1005Metric; MPN CL05B104KO5NNNC; LCSC C1525
J10, J11: DF40C-100DS; CM5_DF40C-100DS-0.4V; MPN DF40C-100DS-0.4V(51); LCSC C597931
M1: CM5 module; CM5_Module_Mechanical; MPN CM5104000 (CM5 Lite, Wireless, 4GB)
R1: 0R; R_0402_1005Metric; MPN 0402WGF0000TCE; LCSC C17168

Connections:
+3V3: C10.1, C11.1, J10.84 (CM5_3V3_OUT), J10.86 (CM5_3V3_OUT), R1.1; also elsewhere on the board
+5V: C7.1, C8.1, J10.77 (+5V_IN), J10.79 (+5V_IN), J10.81 (+5V_IN), J10.83 (+5V_IN), J10.85 (+5V_IN), J10.87 (+5V_IN); also elsewhere on the board
CC1: J10.94 (CC1); also elsewhere on the board
CC2: J10.96 (CC2); also elsewhere on the board
DBG_RX: J10.51 (GPIO15); also elsewhere on the board
DBG_TX: J10.55 (GPIO14); also elsewhere on the board
ETH0_N: J10.10 (Ethernet_Pair0_N); also elsewhere on the board
ETH0_P: J10.12 (Ethernet_Pair0_P); also elsewhere on the board
ETH1_N: J10.6 (Ethernet_Pair1_N); also elsewhere on the board
ETH1_P: J10.4 (Ethernet_Pair1_P); also elsewhere on the board
ETH2_N: J10.9 (Ethernet_Pair2_N); also elsewhere on the board
ETH2_P: J10.11 (Ethernet_Pair2_P); also elsewhere on the board
ETH3_N: J10.5 (Ethernet_Pair3_N); also elsewhere on the board
ETH3_P: J10.3 (Ethernet_Pair3_P); also elsewhere on the board
ETH_LED2_N: J10.17 (Ethernet_nLED2); also elsewhere on the board
ETH_LED3_N: J10.15 (Ethernet_nLED3); also elsewhere on the board
FAN_PWM: J10.19 (FAN_PWM); also elsewhere on the board
FAN_TACH: J10.16 (FAN_TACHO); also elsewhere on the board
GND: C7.2, C8.2, C10.2, C11.2, J10.1 (GND), J10.2 (GND), J10.7 (GND), J10.8 (GND), J10.13 (GND), J10.14 (GND), J10.22 (GND), J10.23 (GND), J10.32 (GND), J10.33 (GND), J10.42 (GND), J10.43 (GND), J10.52 (GND), J10.53 (GND), J10.59 (GND), J10.60 (GND), J10.65 (GND), J10.66 (GND), J10.71 (GND), J10.74 (GND), J10.98 (GND), J11.7 (GND), J11.8 (GND), J11.13 (GND), J11.14 (GND), J11.19 (GND), J11.20 (GND), J11.25 (GND), J11.26 (GND), J11.31 (GND), J11.32 (GND), J11.37 (GND), J11.38 (GND), J11.44 (GND), J11.50 (GND), J11.55 (GND), J11.56 (GND), J11.61 (GND), J11.62 (GND), J11.67 (GND), J11.68 (GND), J11.73 (GND), J11.74 (GND), J11.79 (GND), J11.80 (GND), J11.85 (GND), J11.86 (GND), J11.91 (GND), J11.92 (GND), J11.97 (GND), J11.98 (GND); also elsewhere on the board
GPIO_VREF: J10.78 (GPIO_VREF), R1.2
HUB_UP_N: J11.65 (USB3-1-D_N); also elsewhere on the board
HUB_UP_P: J11.63 (USB3-1-D_P); also elsewhere on the board
LED_ACT_N: J10.21 (LED_nACT); also elsewhere on the board
LED_PWR_N: J10.95 (LED_nPWR); also elsewhere on the board
PWR_BUT: J10.92 (PWR_BUT); also elsewhere on the board
SD_CLK: J10.57 (SD_CLK); also elsewhere on the board
SD_CMD: J10.62 (SD_CMD); also elsewhere on the board
SD_D0: J10.63 (SD_DAT0); also elsewhere on the board
SD_D1: J10.67 (SD_DAT1); also elsewhere on the board
SD_D2: J10.69 (SD_DAT2); also elsewhere on the board
SD_D3: J10.61 (SD_DAT3); also elsewhere on the board
SD_PWR_ON: J10.75 (SD_PWR_ON); also elsewhere on the board
USB3A_DN: J11.36 (USB3-0-D_N); also elsewhere on the board
USB3A_DP: J11.34 (USB3-0-D_P); also elsewhere on the board
USB3A_RX_N: J11.28 (USB3-0-RX_N); also elsewhere on the board
USB3A_RX_P: J11.30 (USB3-0-RX_P); also elsewhere on the board
USB3A_TX_N: J11.40 (USB3-0-TX_N); also elsewhere on the board
USB3A_TX_P: J11.42 (USB3-0-TX_P); also elsewhere on the board
USBC_DN: J11.3 (USB2_N); also elsewhere on the board
USBC_DP: J11.5 (USB2_P); also elsewhere on the board
VBAT: J10.76 (VBAT); also elsewhere on the board
VBUS_EN: J11.11 (VBUS_EN); also elsewhere on the board
nRPIBOOT: J10.93 (nRPIBOOT); also elsewhere on the board

Notes on the sheet:
Use CM5 *Lite* (no eMMC) wireless variant, e.g. CM5104000. Boots from J5 microSD.
DF40 pad geometry = HA Yellow / CM4IO. Antenna end of module must stay at board edge.

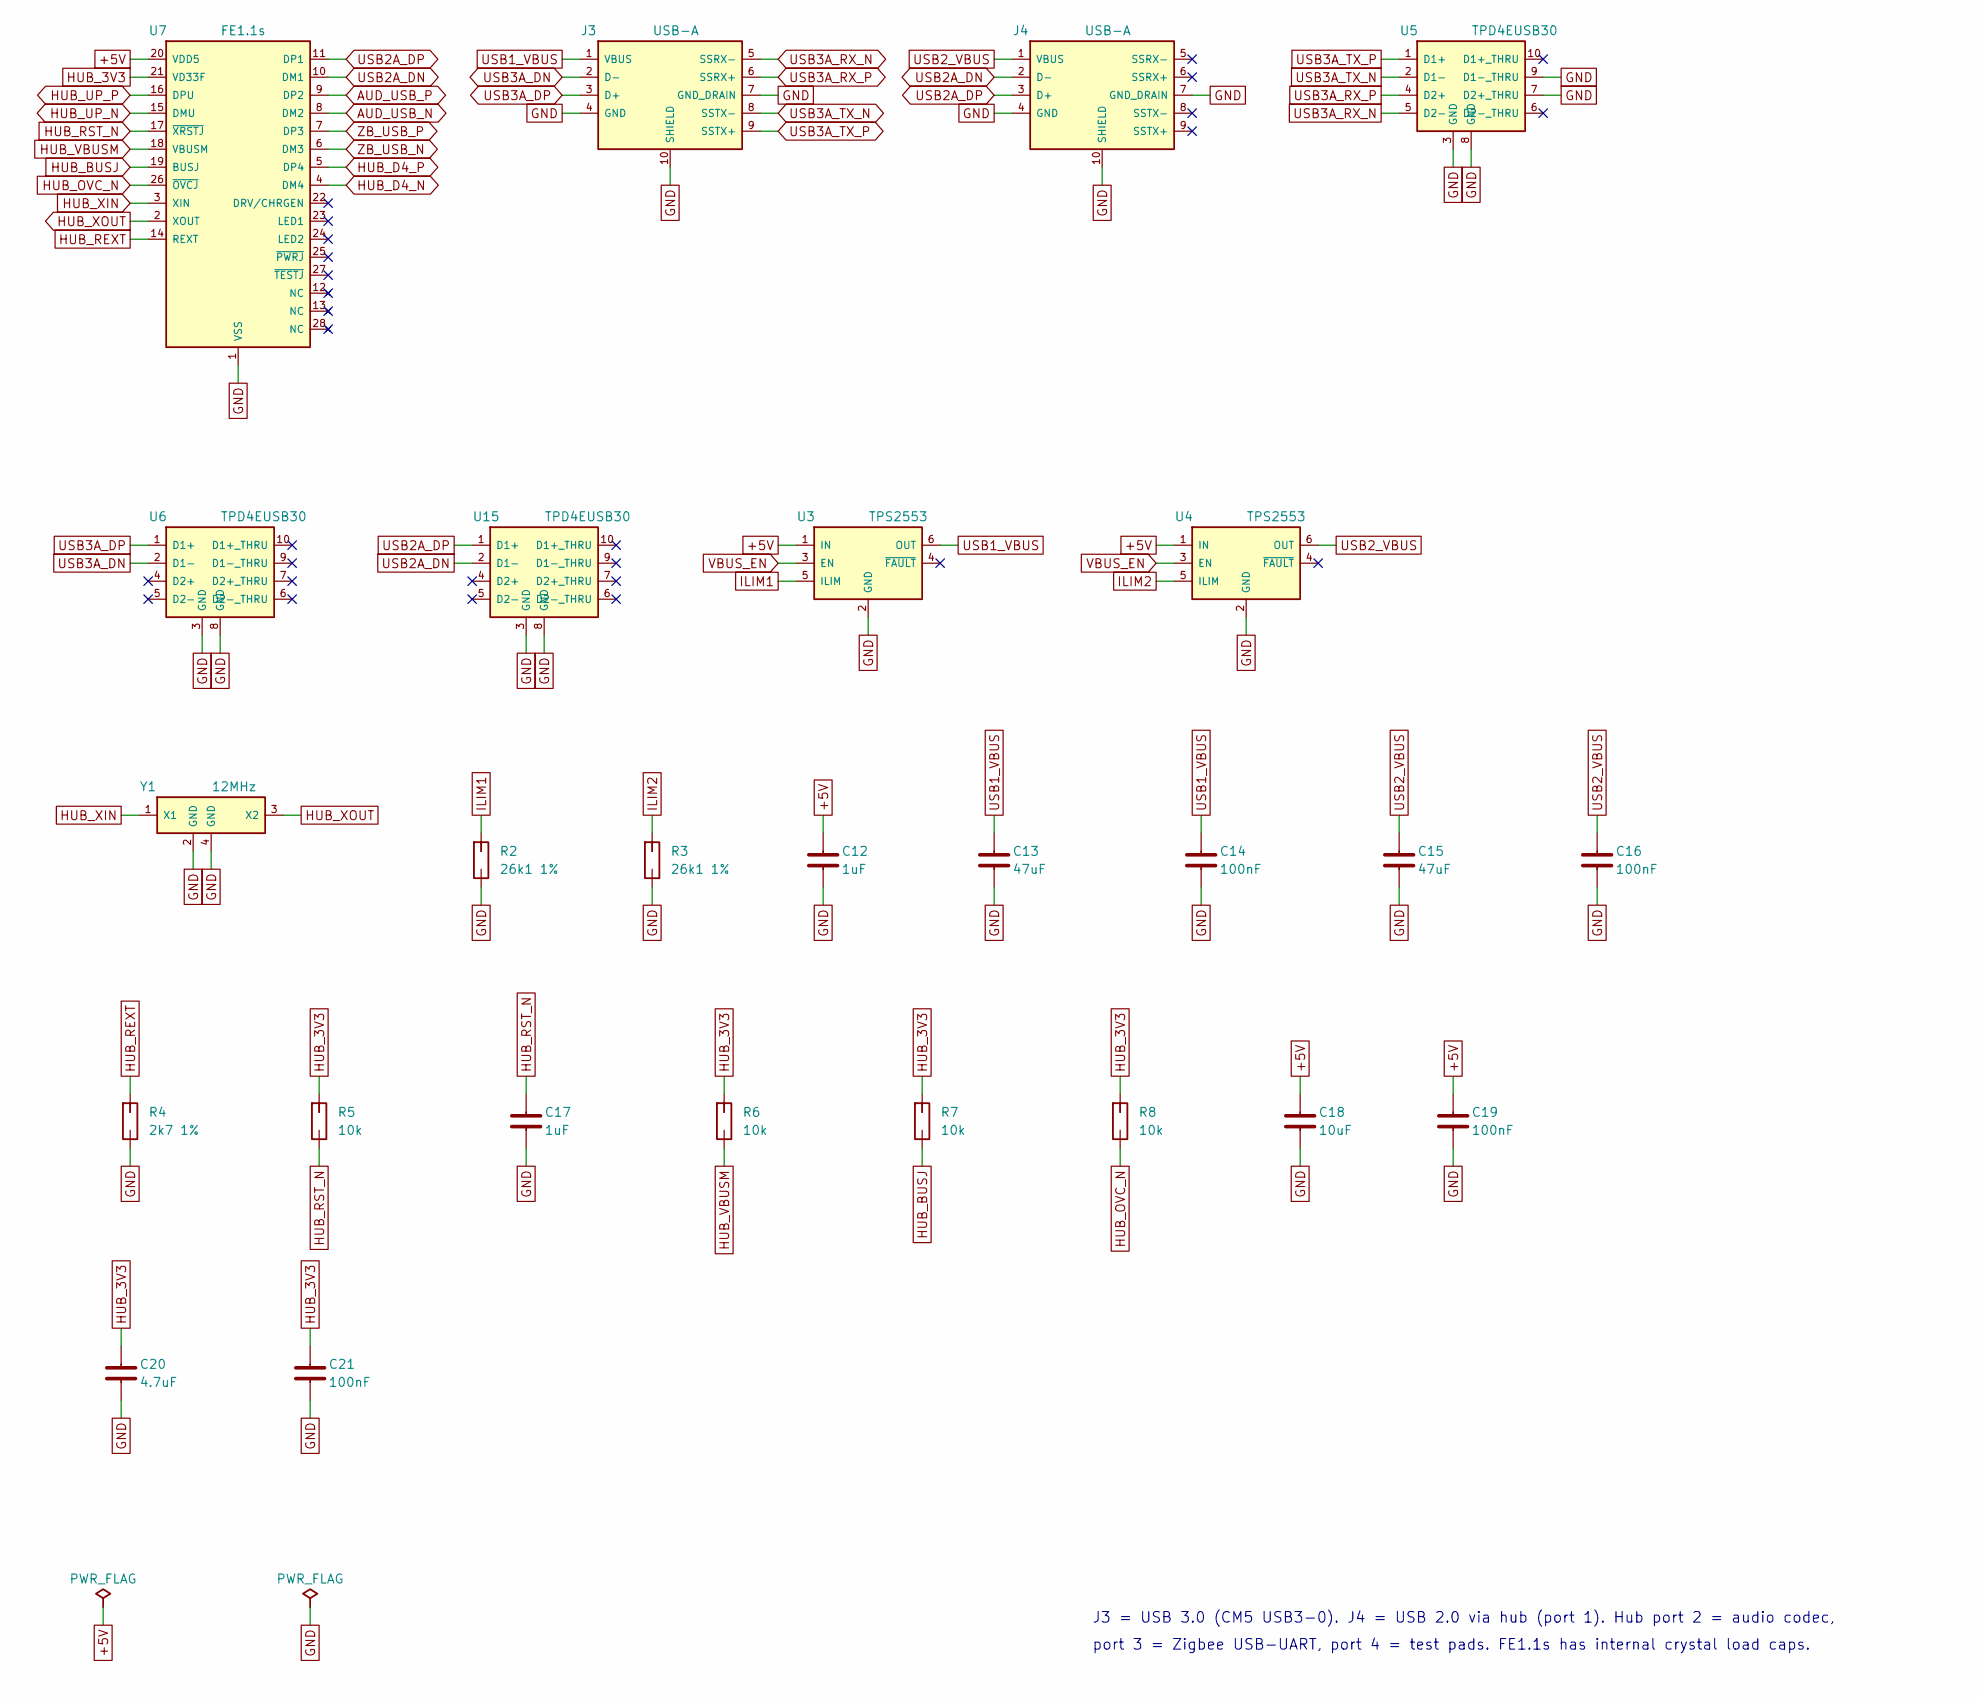
[picture p19: schematic usb.kicad_sch, HVH-1 Home Voice Hub (CM5 carrier)]

Parts:
C12, C17: 1uF; C_0402_1005Metric; MPN CL05A105KA5NQNC; LCSC C52923
C13, C15: 47uF; C_1206_3216Metric; MPN CL31A476MQHNNNE; LCSC C68361
C14, C16, C19, C21: 100nF; C_0402_1005Metric; MPN CL05B104KO5NNNC; LCSC C1525
C18: 10uF; C_0603_1608Metric; MPN CL10A106KP8NNNC; LCSC C19702
C20: 4.7uF; C_0603_1608Metric; MPN CL10A475KO8NNNC; LCSC C19666
J3, J4: USB-A; USB3_A_Amphenol_GSB311131HR; MPN GSB311131HR; LCSC C473057
R2, R3: 26k1 1%; R_0402_1005Metric; MPN RC0402FR-0726K1L; LCSC C155697
R4: 2k7 1%; R_0402_1005Metric; MPN 0402WGF2701TCE; LCSC C25885
R5, R6, R7, R8: 10k; R_0402_1005Metric; MPN 0402WGF1002TCE; LCSC C25744
U3, U4: TPS2553; SOT-23-6; MPN TPS2553DBVR; LCSC C55266
U5, U6, U15: TPD4EUSB30; USON-10_2.5x1.0mm_P0.5mm; MPN TPD4EUSB30DQAR; LCSC C90627
U7: FE1.1s; SSOP-28_3.9x9.9mm_P0.635mm; MPN FE1.1S-BSOP28BCN; LCSC C9359
Y1: 12MHz; Crystal_SMD_3225-4Pin_3.2x2.5mm; MPN X322512MSB4SI; LCSC C9002

Connections:
+5V: C12.1, C18.1, C19.1, U3.1 (IN), U4.1 (IN), U7.20 (VDD5); also elsewhere on the board
AUD_USB_N: U7.8 (DM2); also elsewhere on the board
AUD_USB_P: U7.9 (DP2); also elsewhere on the board
GND: C12.2, C13.2, C14.2, C15.2, C16.2, C17.2, C18.2, C19.2, C20.2, C21.2, J3.4 (GND), J3.7 (GND_DRAIN), J3.10 (SHIELD), J4.4 (GND), J4.7 (GND_DRAIN), J4.10 (SHIELD), R2.2, R3.2, R4.2, U3.2 (GND), U4.2 (GND), U5.3 (GND), U5.7 (D2+_THRU), U5.8 (GND), U5.9 (D1-_THRU), U6.3 (GND), U6.8 (GND), U7.1 (VSS), U15.3 (GND), U15.8 (GND), Y1.2 (GND), Y1.4 (GND); also elsewhere on the board
HUB_3V3: C20.1, C21.1, R5.1, R6.1, R7.1, R8.1, U7.21 (VD33F)
HUB_BUSJ: R7.2, U7.19 (BUSJ)
HUB_D4_N: U7.4 (DM4); also elsewhere on the board
HUB_D4_P: U7.5 (DP4); also elsewhere on the board
HUB_OVC_N: R8.2, U7.26 (~OVCJ)
HUB_REXT: R4.1, U7.14 (REXT)
HUB_RST_N: C17.1, R5.2, U7.17 (~XRSTJ)
HUB_UP_N: U7.15 (DMU); also elsewhere on the board
HUB_UP_P: U7.16 (DPU); also elsewhere on the board
HUB_VBUSM: R6.2, U7.18 (VBUSM)
HUB_XIN: U7.3 (XIN), Y1.1 (X1)
HUB_XOUT: U7.2 (XOUT), Y1.3 (X2)
ILIM1: R2.1, U3.5 (ILIM)
ILIM2: R3.1, U4.5 (ILIM)
USB1_VBUS: C13.1, C14.1, J3.1 (VBUS), U3.6 (OUT)
USB2A_DN: J4.2 (D-), U7.10 (DM1), U15.2 (D1-)
USB2A_DP: J4.3 (D+), U7.11 (DP1), U15.1 (D1+)
USB2_VBUS: C15.1, C16.1, J4.1 (VBUS), U4.6 (OUT)
USB3A_DN: J3.2 (D-), U6.2 (D1-); also elsewhere on the board
USB3A_DP: J3.3 (D+), U6.1 (D1+); also elsewhere on the board
USB3A_RX_N: J3.5 (SSRX-), U5.5 (D2-); also elsewhere on the board
USB3A_RX_P: J3.6 (SSRX+), U5.4 (D2+); also elsewhere on the board
USB3A_TX_N: J3.8 (SSTX-), U5.2 (D1-); also elsewhere on the board
USB3A_TX_P: J3.9 (SSTX+), U5.1 (D1+); also elsewhere on the board
VBUS_EN: U3.3 (EN), U4.3 (EN); also elsewhere on the board
ZB_USB_N: U7.6 (DM3); also elsewhere on the board
ZB_USB_P: U7.7 (DP3); also elsewhere on the board

Notes on the sheet:
J3 = USB 3.0 (CM5 USB3-0). J4 = USB 2.0 via hub (port 1). Hub port 2 = audio codec,
port 3 = Zigbee USB-UART, port 4 = test pads. FE1.1s has internal crystal load caps.

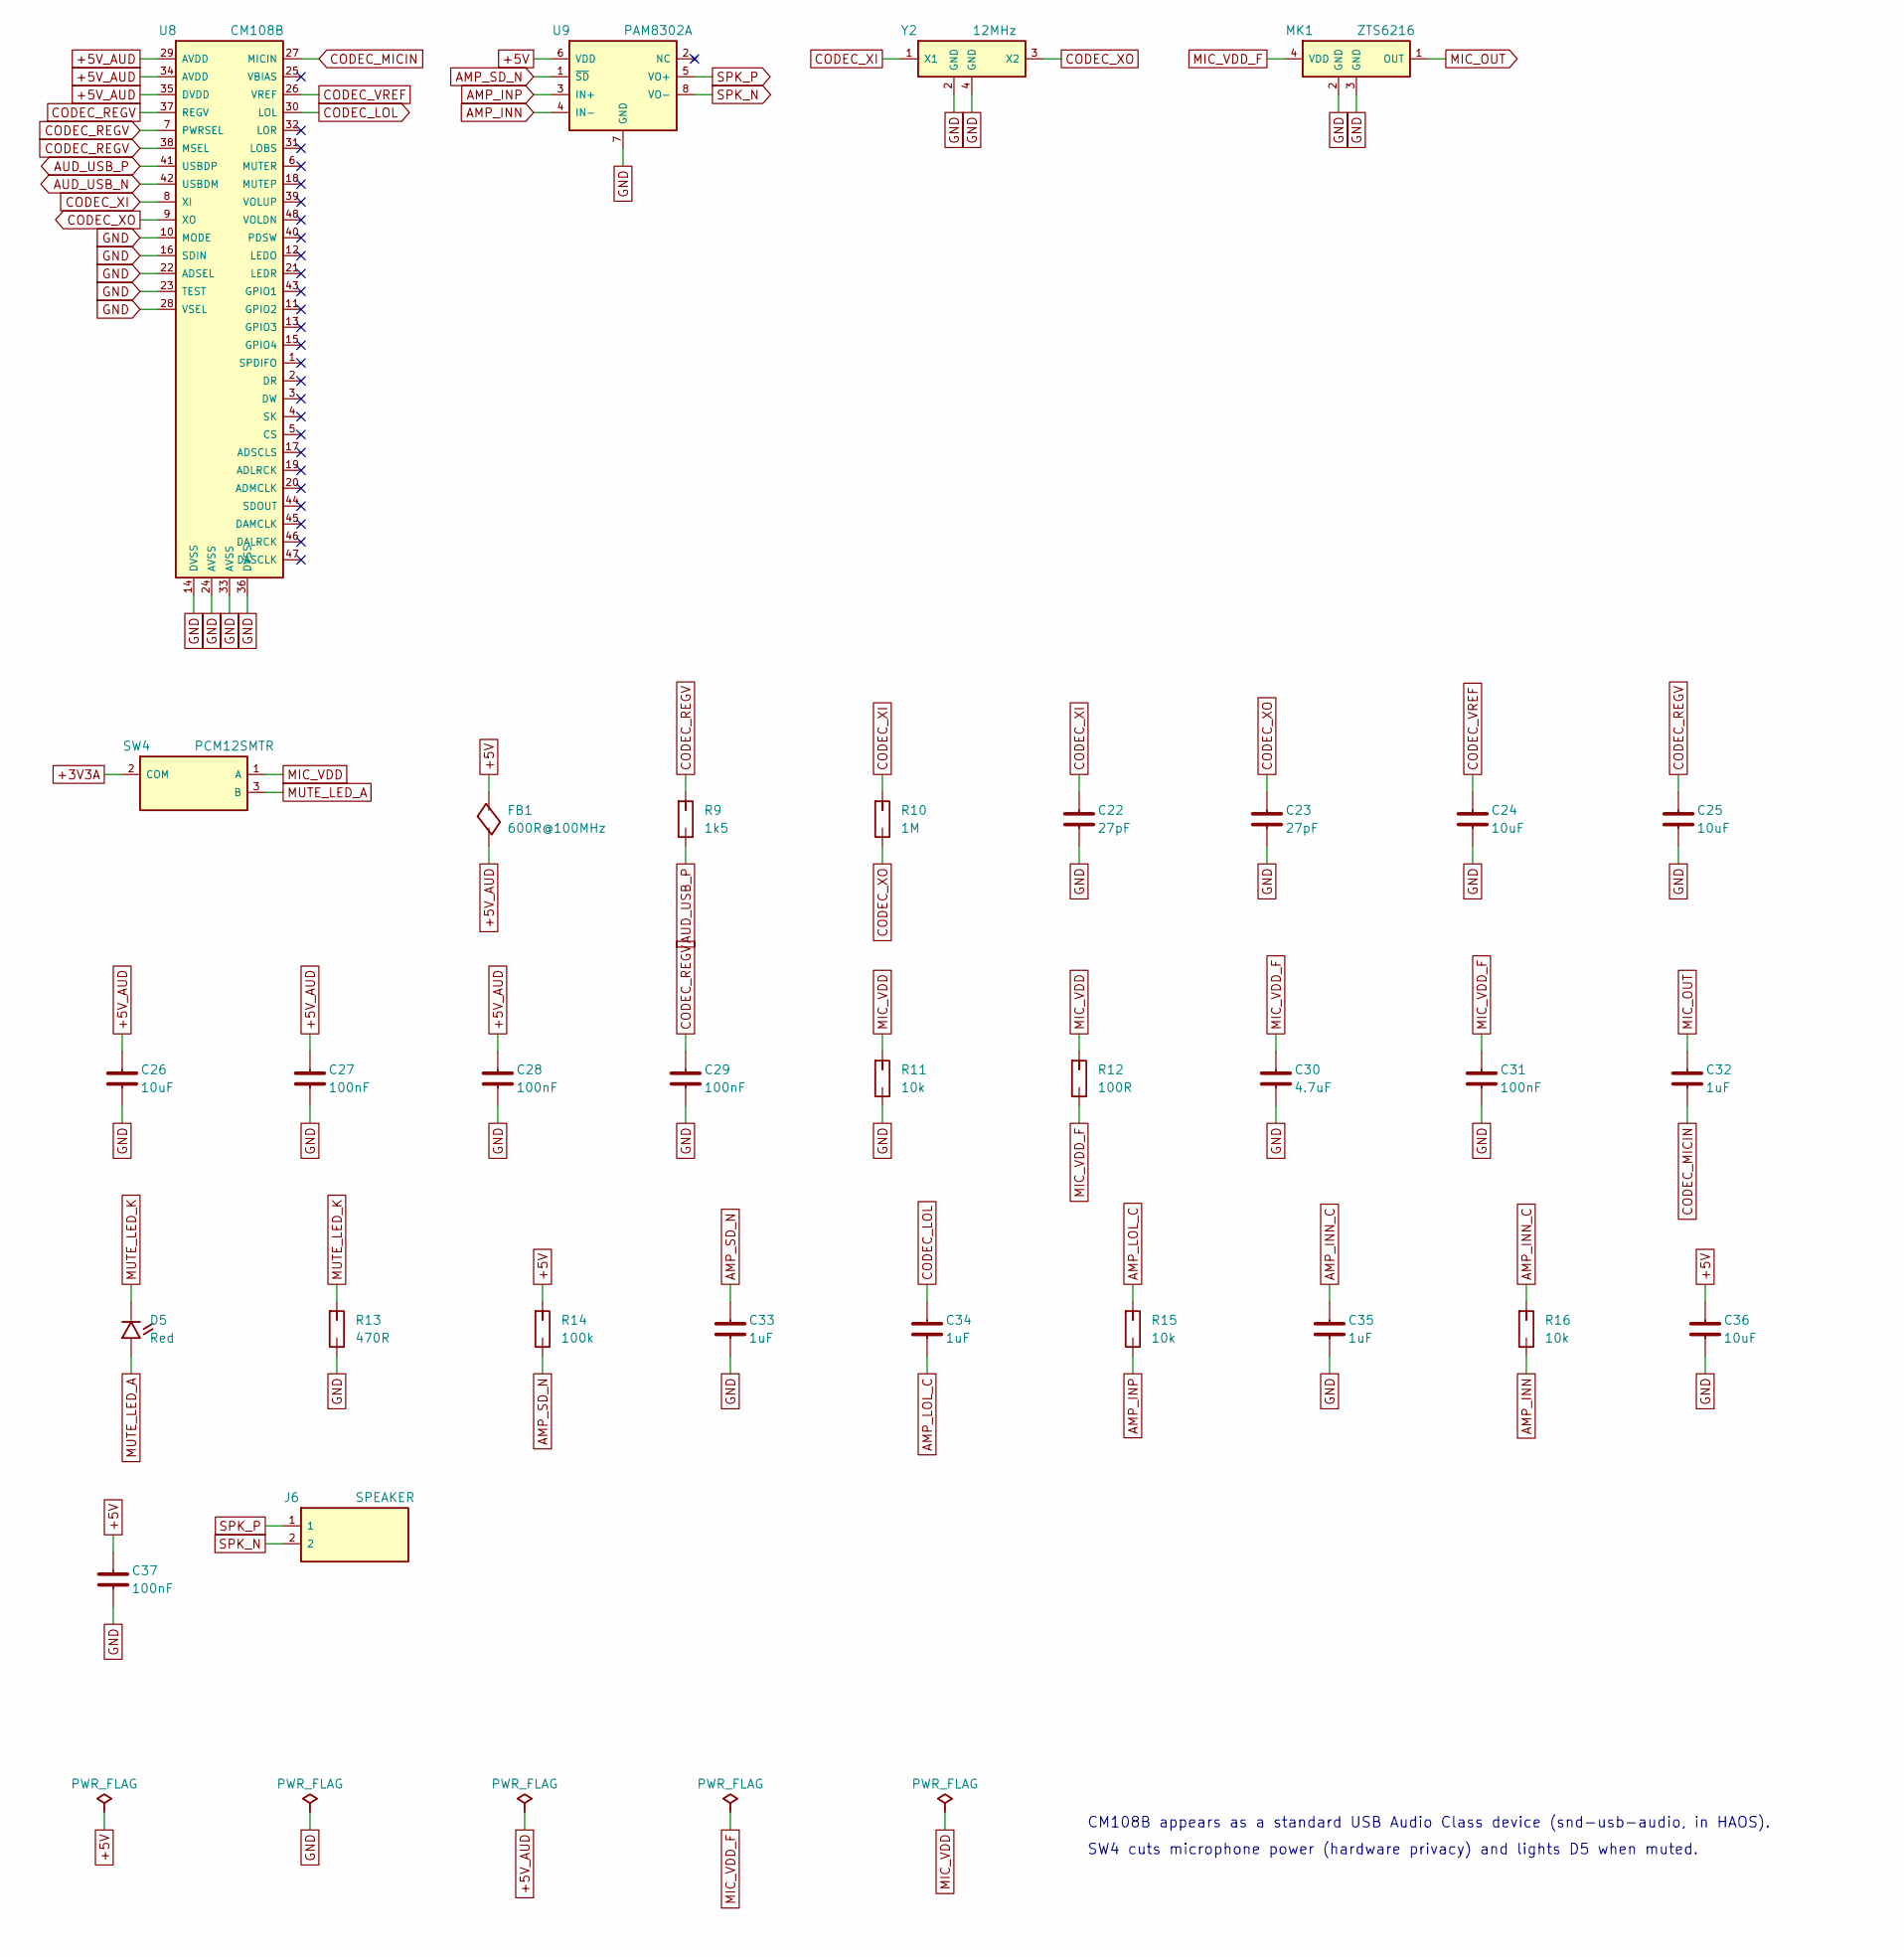
[picture p20: schematic audio.kicad_sch, HVH-1 Home Voice Hub (CM5 carrier)]

Parts:
C22, C23: 27pF; C_0402_1005Metric; MPN 0402CG270J500NT; LCSC C1557
C24, C25, C26: 10uF; C_0603_1608Metric; MPN CL10A106KP8NNNC; LCSC C19702
C27, C28, C29, C31, C37: 100nF; C_0402_1005Metric; MPN CL05B104KO5NNNC; LCSC C1525
C30: 4.7uF; C_0603_1608Metric; MPN CL10A475KO8NNNC; LCSC C19666
C32, C33, C34, C35: 1uF; C_0402_1005Metric; MPN CL05A105KA5NQNC; LCSC C52923
C36: 10uF; C_0805_2012Metric; MPN CL21A106KAYNNNE; LCSC C15850
D5: Red; LED_0603_1608Metric; MPN KT-0603R; LCSC C2286
FB1: 600R@100MHz; L_0603_1608Metric; MPN GZ1608D601TF; LCSC C1002
J6: SPEAKER; JST_PH_S2B-PH-K_1x02_P2.00mm_Horizontal; MPN S2B-PH-K-S(LF)(SN); LCSC C173752
MK1: ZTS6216; MIC_ZTS6216; MPN ZTS6216; LCSC C481302
R9: 1k5; R_0402_1005Metric; MPN 0402WGF1501TCE; LCSC C25867
R10: 1M; R_0402_1005Metric; MPN 0402WGF1004TCE; LCSC C26083
R11, R15, R16: 10k; R_0402_1005Metric; MPN 0402WGF1002TCE; LCSC C25744
R12: 100R; R_0402_1005Metric; MPN 0402WGF1000TCE; LCSC C25076
R13: 470R; R_0402_1005Metric; MPN 0402WGF4700TCE; LCSC C25117
R14: 100k; R_0402_1005Metric; MPN 0402WGF1003TCE; LCSC C25741
SW4: PCM12SMTR; SW_SPDT_PCM12; MPN PCM12SMTR; LCSC C221841
U8: CM108B; LQFP-48_7x7mm_P0.5mm; MPN CM108B; LCSC C371347
U9: PAM8302A; MSOP-8_3x3mm_P0.65mm; MPN PAM8302AASCR; LCSC C113367
Y2: 12MHz; Crystal_SMD_3225-4Pin_3.2x2.5mm; MPN X322512MSB4SI; LCSC C9002

Connections:
+3V3A: SW4.2 (COM); also elsewhere on the board
+5V: C36.1, C37.1, FB1.1, R14.1, U9.6 (VDD); also elsewhere on the board
+5V_AUD: C26.1, C27.1, C28.1, FB1.2, U8.29 (AVDD), U8.34 (AVDD), U8.35 (DVDD)
AMP_INN: R16.2, U9.4 (IN-)
AMP_INN_C: C35.1, R16.1
AMP_INP: R15.2, U9.3 (IN+)
AMP_LOL_C: C34.2, R15.1
AMP_SD_N: C33.1, R14.2, U9.1 (~SD)
AUD_USB_N: U8.42 (USBDM); also elsewhere on the board
AUD_USB_P: R9.2, U8.41 (USBDP); also elsewhere on the board
CODEC_LOL: C34.1, U8.30 (LOL)
CODEC_MICIN: C32.2, U8.27 (MICIN)
CODEC_REGV: C25.1, C29.1, R9.1, U8.7 (PWRSEL), U8.37 (REGV), U8.38 (MSEL)
CODEC_VREF: C24.1, U8.26 (VREF)
CODEC_XI: C22.1, R10.1, U8.8 (XI), Y2.1 (X1)
CODEC_XO: C23.1, R10.2, U8.9 (XO), Y2.3 (X2)
GND: C22.2, C23.2, C24.2, C25.2, C26.2, C27.2, C28.2, C29.2, C30.2, C31.2, C33.2, C35.2, C36.2, C37.2, MK1.2 (GND), MK1.3 (GND), R11.2, R13.2, U8.10 (MODE), U8.14 (DVSS), U8.16 (SDIN), U8.22 (ADSEL), U8.23 (TEST), U8.24 (AVSS), U8.28 (VSEL), U8.33 (AVSS), U8.36 (DVSS), U9.7 (GND), Y2.2 (GND), Y2.4 (GND); also elsewhere on the board
MIC_OUT: C32.1, MK1.1 (OUT)
MIC_VDD: R11.1, R12.1, SW4.1 (A)
MIC_VDD_F: C30.1, C31.1, MK1.4 (VDD), R12.2
MUTE_LED_A: D5.2, SW4.3 (B)
MUTE_LED_K: D5.1, R13.1
SPK_N: J6.2, U9.8 (VO-)
SPK_P: J6.1, U9.5 (VO+)

Notes on the sheet:
CM108B appears as a standard USB Audio Class device (snd-usb-audio, in HAOS).
SW4 cuts microphone power (hardware privacy) and lights D5 when muted.
