hexadecim/home-voice-hub/kicad/hvh.kicad_pcb

## KiCad design kicad/hvh.kicad_pcb (continued)

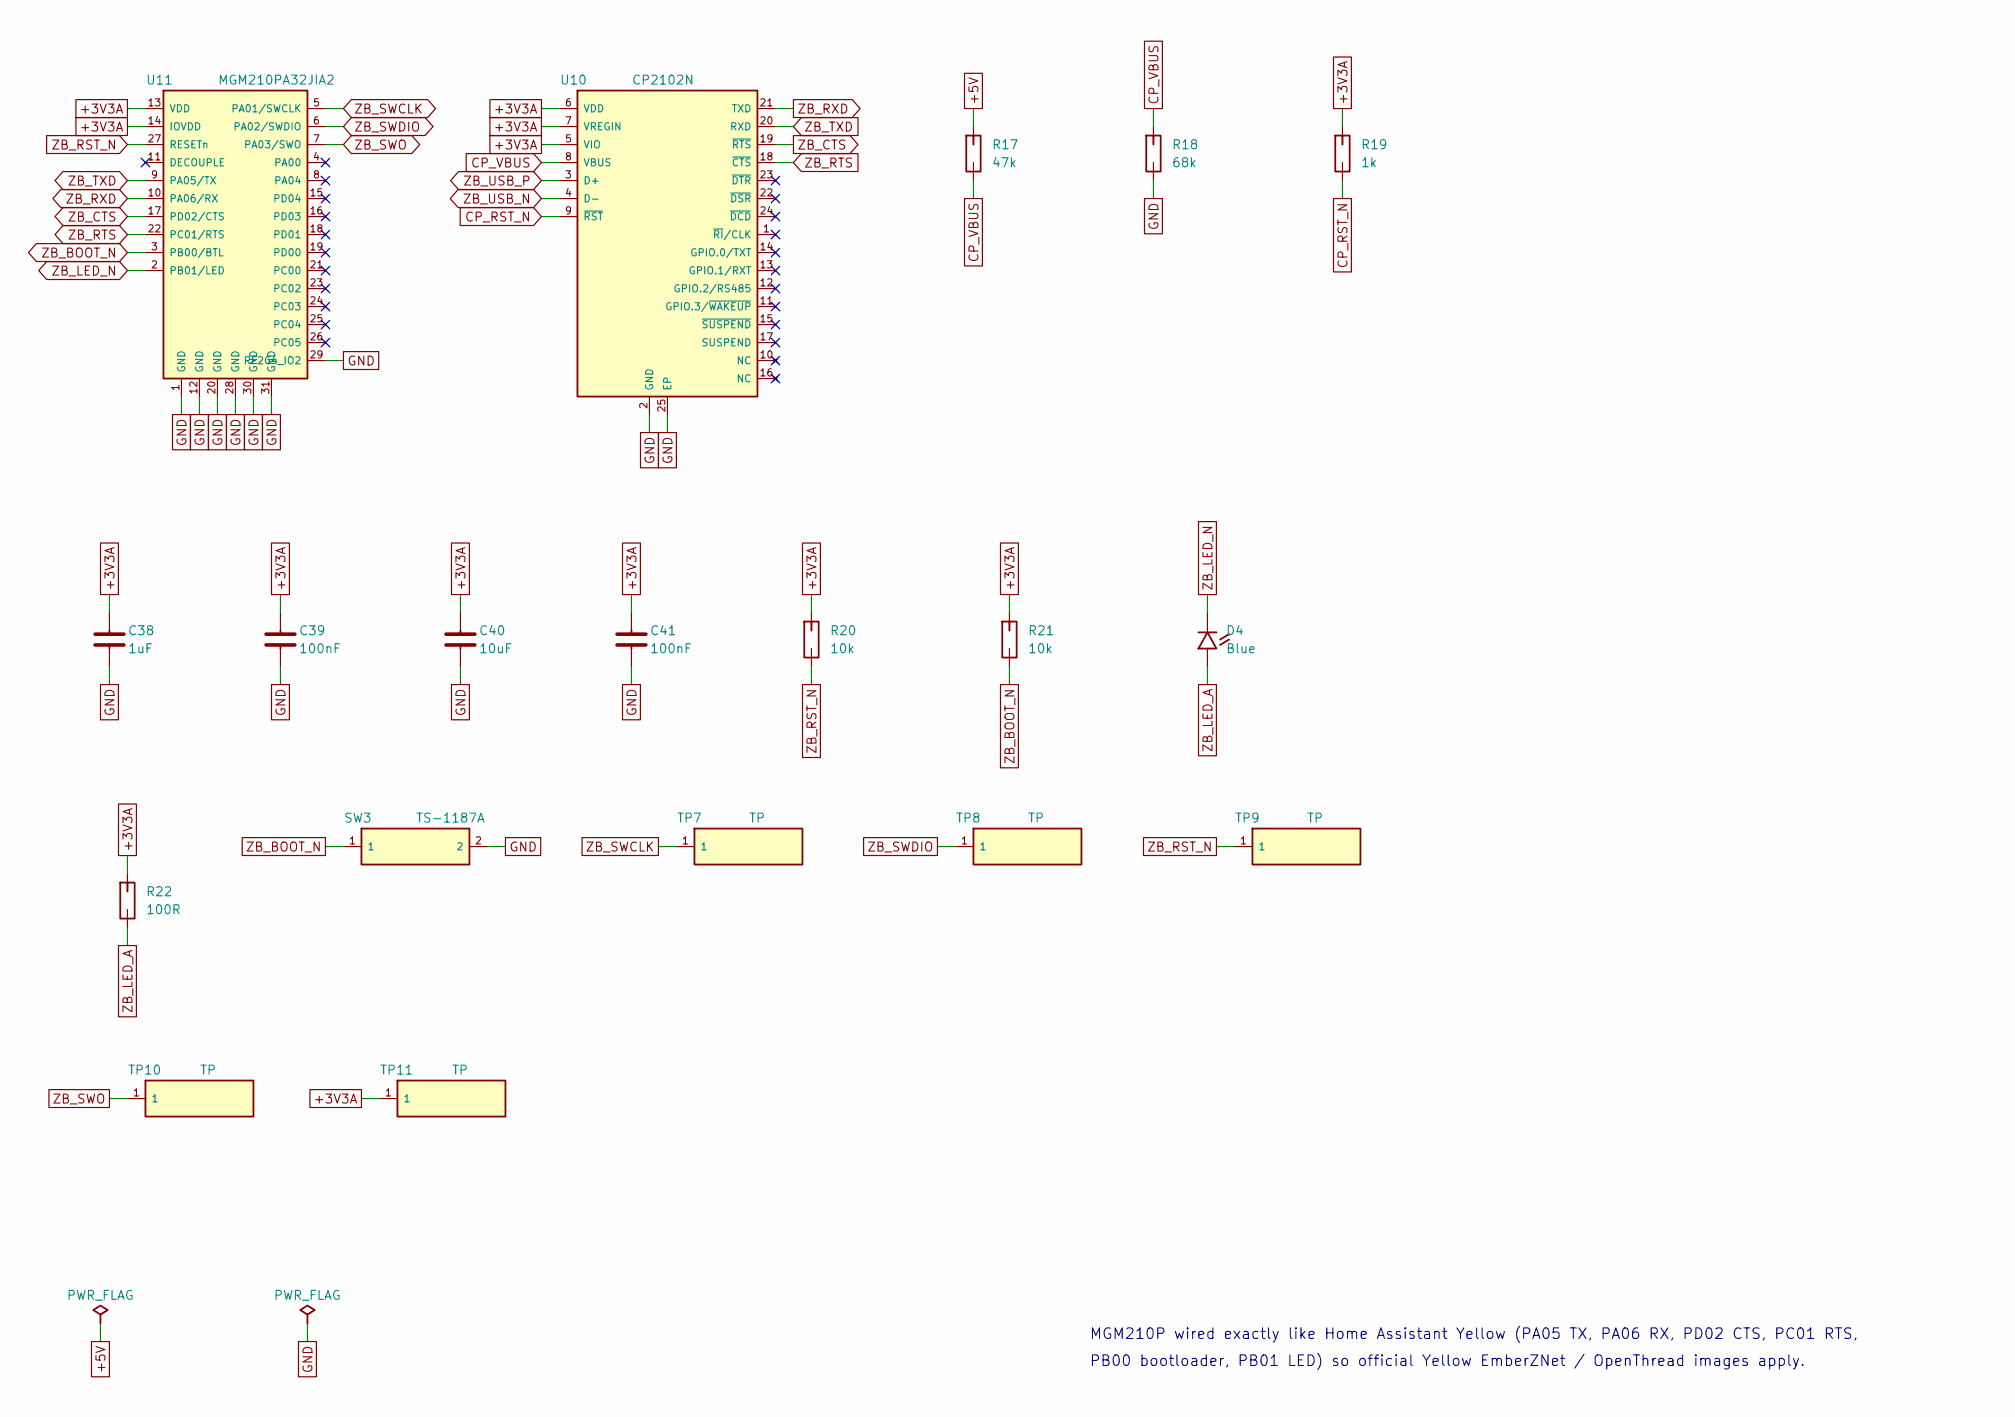
[picture p21: schematic zigbee.kicad_sch, HVH-1 Home Voice Hub (CM5 carrier)]

Parts:
C38: 1uF; C_0402_1005Metric; MPN CL05A105KA5NQNC; LCSC C52923
C39, C41: 100nF; C_0402_1005Metric; MPN CL05B104KO5NNNC; LCSC C1525
C40: 10uF; C_0603_1608Metric; MPN CL10A106KP8NNNC; LCSC C19702
D4: Blue; LED_0603_1608Metric; MPN XL-1608UBC-04; LCSC C965807
R17: 47k; R_0402_1005Metric; MPN 0402WGF4702TCE; LCSC C25792
R18: 68k; R_0402_1005Metric; MPN 0402WGF6802TCE; LCSC C36871
R19: 1k; R_0402_1005Metric; MPN 0402WGF1001TCE; LCSC C11702
R20, R21: 10k; R_0402_1005Metric; MPN 0402WGF1002TCE; LCSC C25744
R22: 100R; R_0402_1005Metric; MPN 0402WGF1000TCE; LCSC C25076
SW3: TS-1187A; SW_Push_1P1T_XKB_TS-1187A; MPN TS-1187A-B-A-B; LCSC C318884
TP7, TP8, TP9, TP10, TP11: TP; TestPoint_Pad_D1.0mm
U10: CP2102N; QFN-24-1EP_4x4mm_P0.5mm_EP2.6x2.6mm; MPN CP2102N-A02-GQFN24R; LCSC C969151
U11: MGM210PA32JIA2; SiliconLabs_MGM210P; MPN MGM210PA32JIA2; LCSC C1864147

Connections:
+3V3A: C38.1, C39.1, C40.1, C41.1, R19.1, R20.1, R21.1, R22.1, TP11.1, U10.5 (VIO), U10.6 (VDD), U10.7 (VREGIN), U11.13 (VDD), U11.14 (IOVDD); also elsewhere on the board
+5V: R17.1; also elsewhere on the board
CP_RST_N: R19.2, U10.9 (~RST)
CP_VBUS: R17.2, R18.1, U10.8 (VBUS)
GND: C38.2, C39.2, C40.2, C41.2, R18.2, SW3.2, U10.2 (GND), U10.25 (EP), U11.1 (GND), U11.12 (GND), U11.20 (GND), U11.28 (GND), U11.29 (RF2G4_IO2), U11.30 (GND), U11.31 (GND); also elsewhere on the board
ZB_BOOT_N: R21.2, SW3.1, U11.3 (PB00/BTL)
ZB_CTS: U10.19 (~RTS), U11.17 (PD02/CTS)
ZB_LED_A: D4.2, R22.2
ZB_LED_N: D4.1, U11.2 (PB01/LED)
ZB_RST_N: R20.2, TP9.1, U11.27 (RESETn)
ZB_RTS: U10.18 (~CTS), U11.22 (PC01/RTS)
ZB_RXD: U10.21 (TXD), U11.10 (PA06/RX)
ZB_SWCLK: TP7.1, U11.5 (PA01/SWCLK)
ZB_SWDIO: TP8.1, U11.6 (PA02/SWDIO)
ZB_SWO: TP10.1, U11.7 (PA03/SWO)
ZB_TXD: U10.20 (RXD), U11.9 (PA05/TX)
ZB_USB_N: U10.4 (D-); also elsewhere on the board
ZB_USB_P: U10.3 (D+); also elsewhere on the board

Notes on the sheet:
MGM210P wired exactly like Home Assistant Yellow (PA05 TX, PA06 RX, PD02 CTS, PC01 RTS,
PB00 bootloader, PB01 LED) so official Yellow EmberZNet / OpenThread images apply.

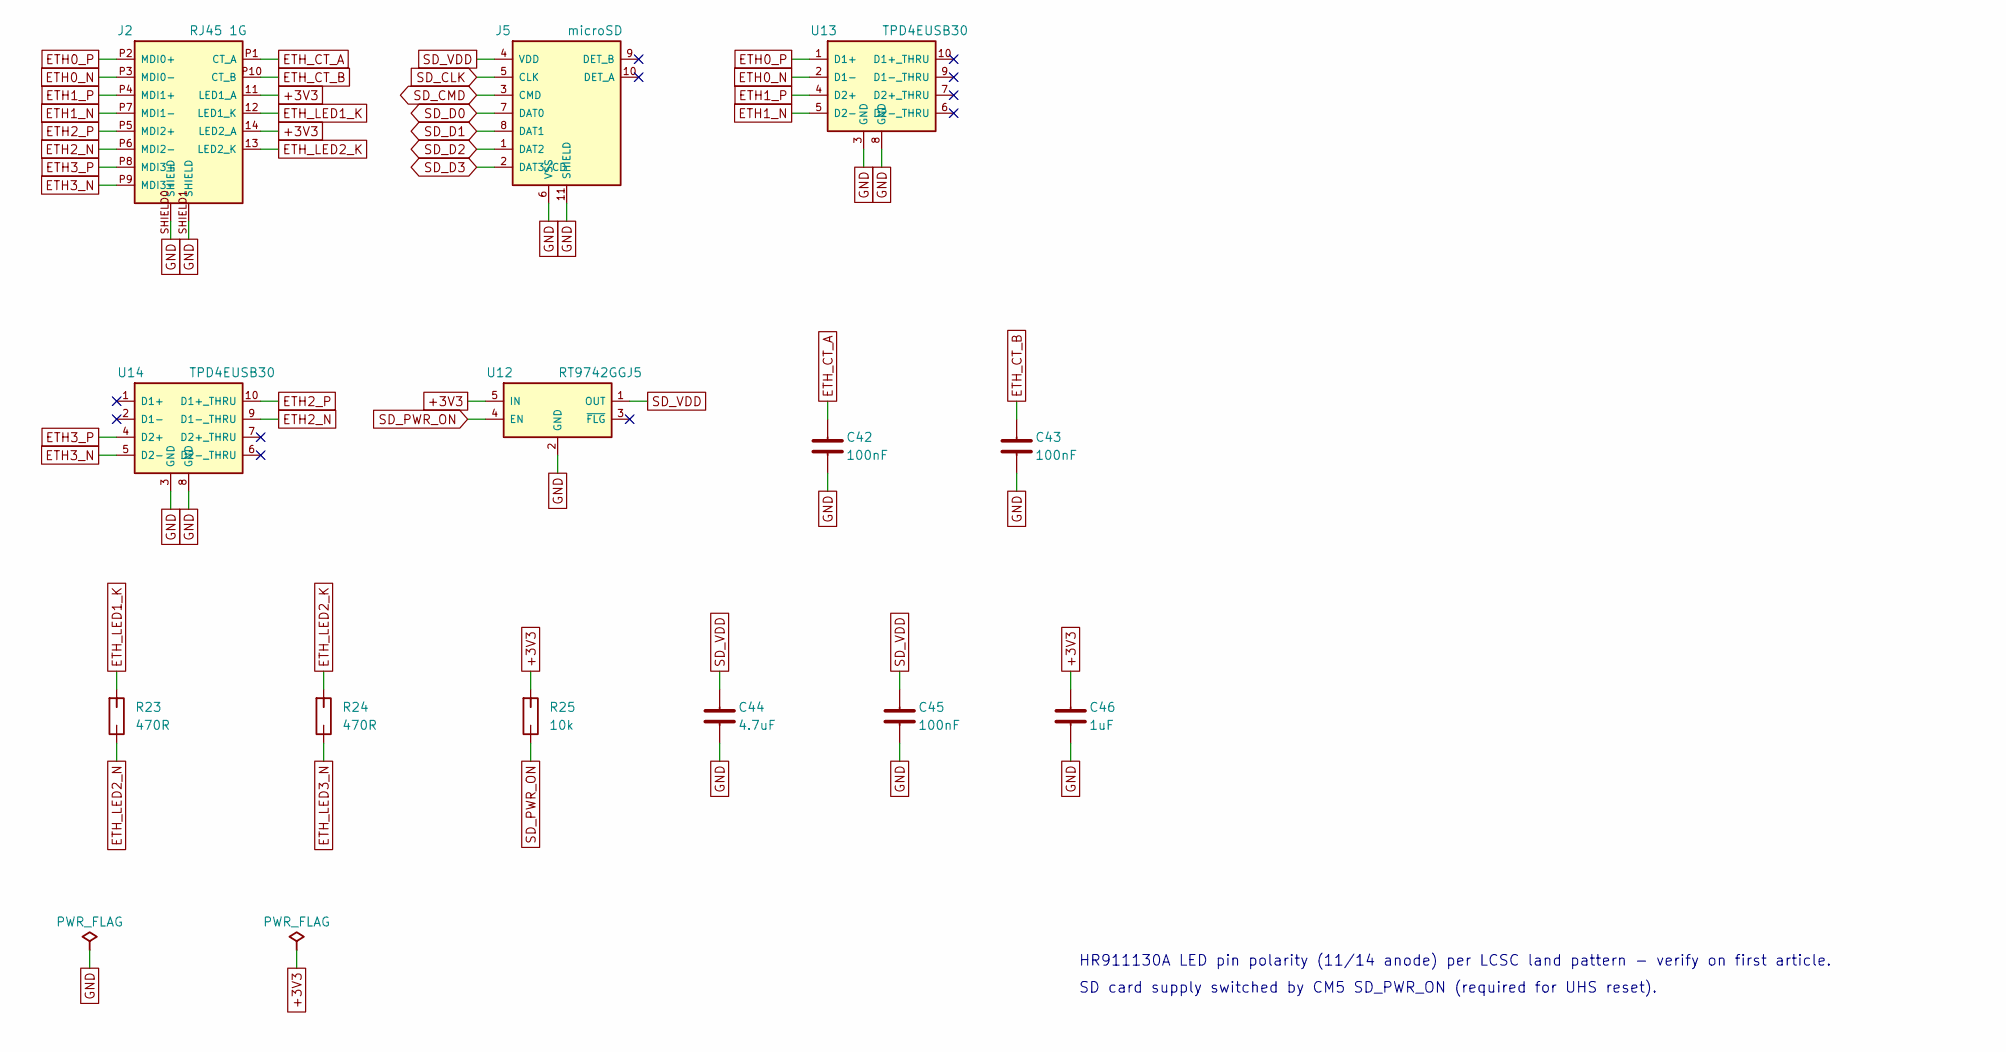
[picture p22: schematic eth_sd.kicad_sch, HVH-1 Home Voice Hub (CM5 carrier)]

Parts:
C42, C43, C45: 100nF; C_0402_1005Metric; MPN CL05B104KO5NNNC; LCSC C1525
C44: 4.7uF; C_0603_1608Metric; MPN CL10A475KO8NNNC; LCSC C19666
C46: 1uF; C_0402_1005Metric; MPN CL05A105KA5NQNC; LCSC C52923
J2: RJ45 1G; RJ45_HanRun_HR911130A; MPN HR911130A; LCSC C54408
J5: microSD; microSD_HC_Molex_104031-0811; MPN 1040310811; LCSC C585350
R23, R24: 470R; R_0402_1005Metric; MPN 0402WGF4700TCE; LCSC C25117
R25: 10k; R_0402_1005Metric; MPN 0402WGF1002TCE; LCSC C25744
U12: RT9742GGJ5; SOT-23-5; MPN RT9742GGJ5; LCSC C250547
U13, U14: TPD4EUSB30; USON-10_2.5x1.0mm_P0.5mm; MPN TPD4EUSB30DQAR; LCSC C90627

Connections:
+3V3: C46.1, J2.11 (LED1_A), J2.14 (LED2_A), R25.1, U12.5 (IN); also elsewhere on the board
ETH0_N: J2.P3 (MDI0-), U13.2 (D1-); also elsewhere on the board
ETH0_P: J2.P2 (MDI0+), U13.1 (D1+); also elsewhere on the board
ETH1_N: J2.P7 (MDI1-), U13.5 (D2-); also elsewhere on the board
ETH1_P: J2.P4 (MDI1+), U13.4 (D2+); also elsewhere on the board
ETH2_N: J2.P6 (MDI2-), U14.9 (D1-_THRU); also elsewhere on the board
ETH2_P: J2.P5 (MDI2+), U14.10 (D1+_THRU); also elsewhere on the board
ETH3_N: J2.P9 (MDI3-), U14.5 (D2-); also elsewhere on the board
ETH3_P: J2.P8 (MDI3+), U14.4 (D2+); also elsewhere on the board
ETH_CT_A: C42.1, J2.P1 (CT_A)
ETH_CT_B: C43.1, J2.P10 (CT_B)
ETH_LED1_K: J2.12 (LED1_K), R23.1
ETH_LED2_K: J2.13 (LED2_K), R24.1
ETH_LED2_N: R23.2; also elsewhere on the board
ETH_LED3_N: R24.2; also elsewhere on the board
GND: C42.2, C43.2, C44.2, C45.2, C46.2, J2.SHIELD0 (SHIELD), J2.SHIELD1 (SHIELD), J5.6 (VSS), J5.11 (SHIELD), U12.2 (GND), U13.3 (GND), U13.8 (GND), U14.3 (GND), U14.8 (GND); also elsewhere on the board
SD_CLK: J5.5 (CLK); also elsewhere on the board
SD_CMD: J5.3 (CMD); also elsewhere on the board
SD_D0: J5.7 (DAT0); also elsewhere on the board
SD_D1: J5.8 (DAT1); also elsewhere on the board
SD_D2: J5.1 (DAT2); also elsewhere on the board
SD_D3: J5.2 (DAT3/CD); also elsewhere on the board
SD_PWR_ON: R25.2, U12.4 (EN); also elsewhere on the board
SD_VDD: C44.1, C45.1, J5.4 (VDD), U12.1 (OUT); also elsewhere on the board

Notes on the sheet:
HR911130A LED pin polarity (11/14 anode) per LCSC land pattern - verify on first article.
SD card supply switched by CM5 SD_PWR_ON (required for UHS reset).

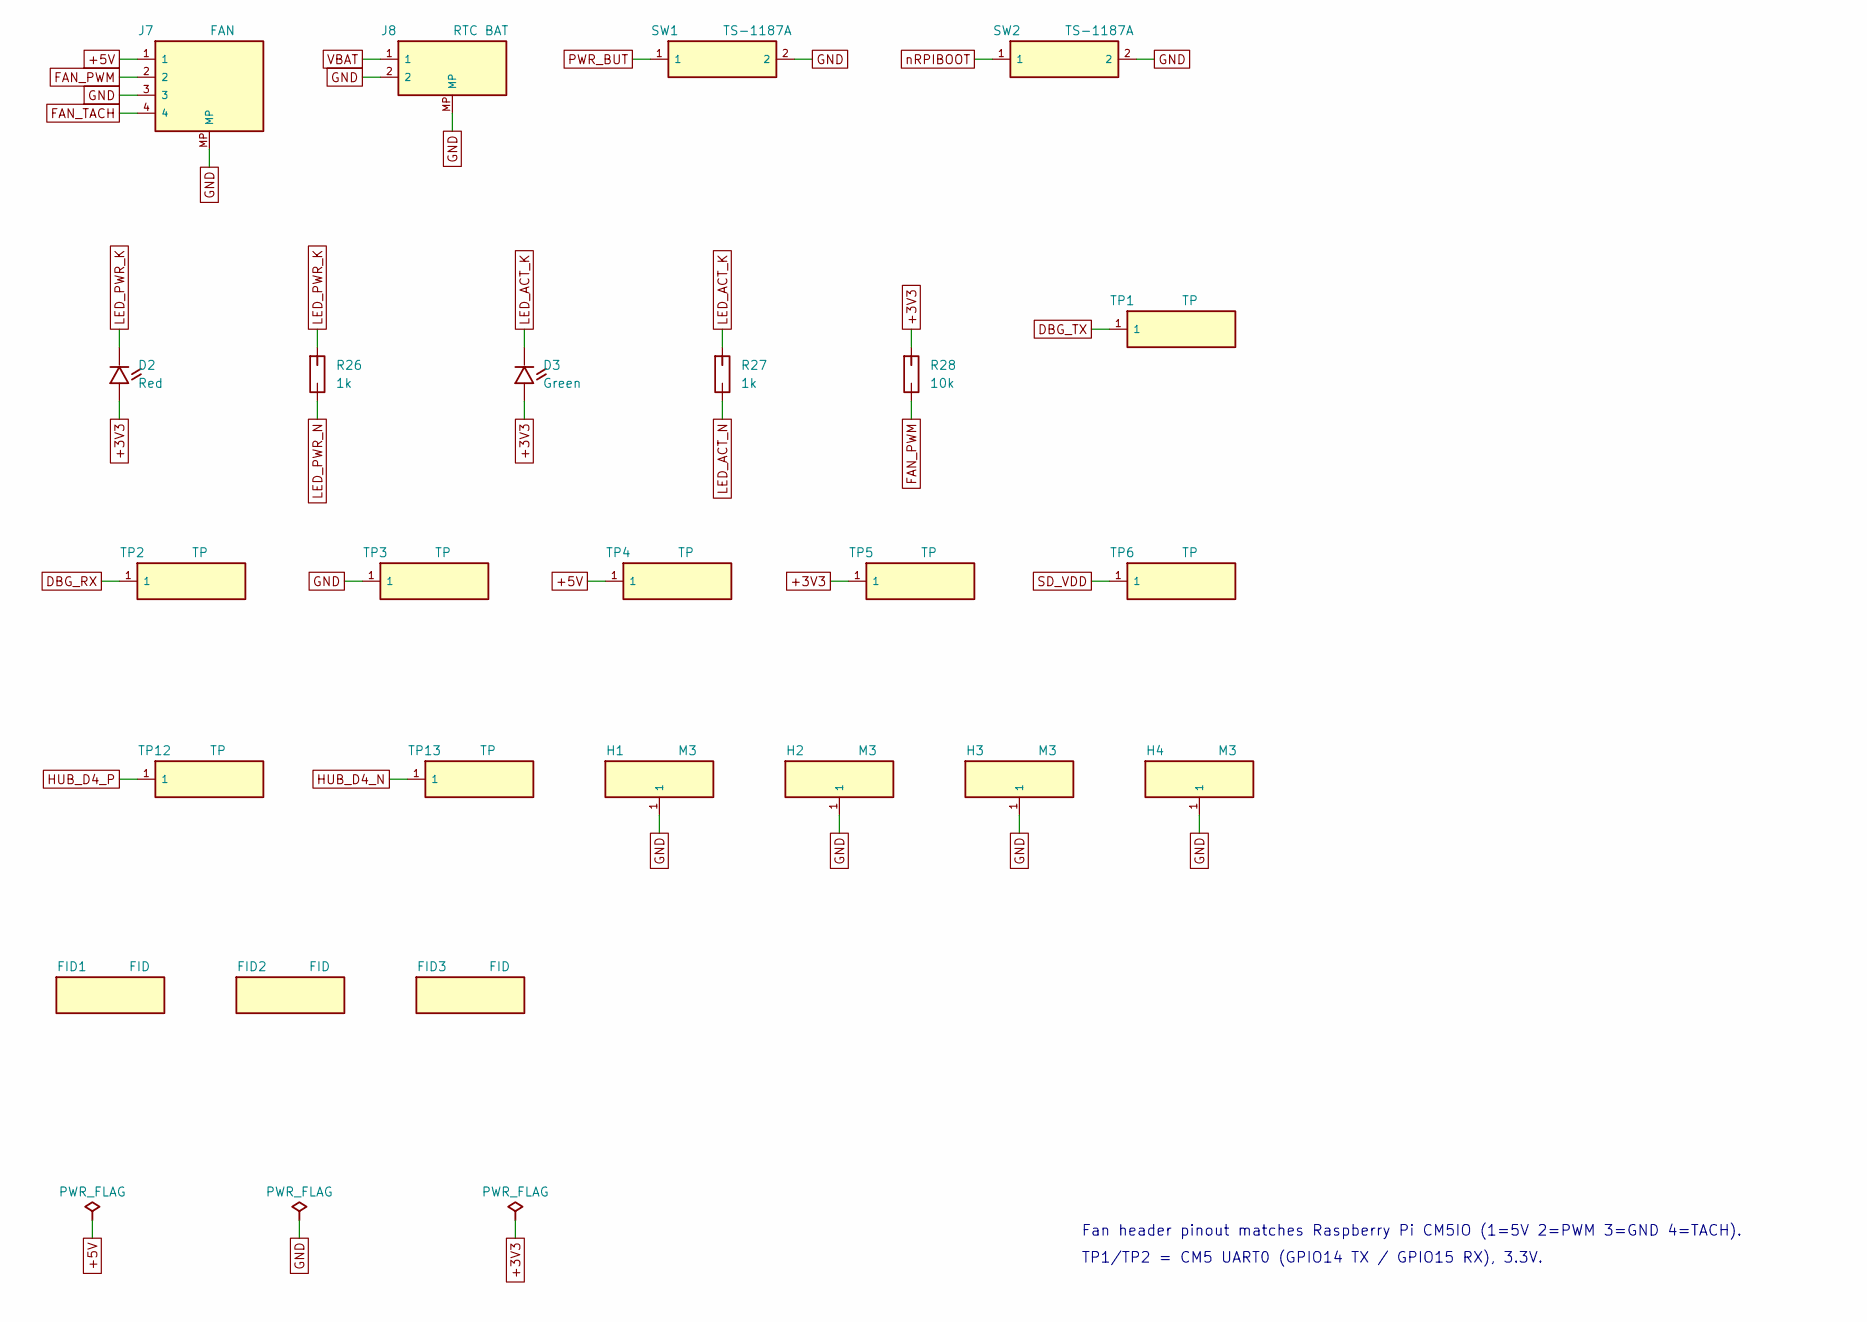
[picture p23: schematic ui.kicad_sch, HVH-1 Home Voice Hub (CM5 carrier)]

Parts:
D2: Red; LED_0603_1608Metric; MPN KT-0603R; LCSC C2286
D3: Green; LED_0603_1608Metric; MPN XL-1608UGC-04; LCSC C965804
FID1, FID2, FID3: FID; Fiducial_1mm_Mask2mm
H1, H2, H3, H4: M3; MountingHole_3.2mm_M3_Pad_Via
J7: FAN; JST_SH_SM04B-SRSS-TB_1x04-1MP_P1.00mm_Horizontal; MPN SM04B-SRSS-TB(LF)(SN); LCSC C160404
J8: RTC BAT; JST_SH_SM02B-SRSS-TB_1x02-1MP_P1.00mm_Horizontal; MPN SM02B-SRSS-TB(LF)(SN); LCSC C160402
R26, R27: 1k; R_0402_1005Metric; MPN 0402WGF1001TCE; LCSC C11702
R28: 10k; R_0402_1005Metric; MPN 0402WGF1002TCE; LCSC C25744
SW1, SW2: TS-1187A; SW_Push_1P1T_XKB_TS-1187A; MPN TS-1187A-B-A-B; LCSC C318884
TP1, TP2, TP3, TP4, TP5, TP6, TP12, TP13: TP; TestPoint_Pad_D1.0mm

Connections:
+3V3: D2.2, D3.2, R28.1, TP5.1; also elsewhere on the board
+5V: J7.1, TP4.1; also elsewhere on the board
DBG_RX: TP2.1; also elsewhere on the board
DBG_TX: TP1.1; also elsewhere on the board
FAN_PWM: J7.2, R28.2; also elsewhere on the board
FAN_TACH: J7.4; also elsewhere on the board
GND: H1.1, H2.1, H3.1, H4.1, J7.3, J7.MP, J8.2, J8.MP, SW1.2, SW2.2, TP3.1; also elsewhere on the board
HUB_D4_N: TP13.1; also elsewhere on the board
HUB_D4_P: TP12.1; also elsewhere on the board
LED_ACT_K: D3.1, R27.1
LED_ACT_N: R27.2; also elsewhere on the board
LED_PWR_K: D2.1, R26.1
LED_PWR_N: R26.2; also elsewhere on the board
PWR_BUT: SW1.1; also elsewhere on the board
SD_VDD: TP6.1; also elsewhere on the board
VBAT: J8.1; also elsewhere on the board
nRPIBOOT: SW2.1; also elsewhere on the board

Notes on the sheet:
Fan header pinout matches Raspberry Pi CM5IO (1=5V 2=PWM 3=GND 4=TACH).
TP1/TP2 = CM5 UART0 (GPIO14 TX / GPIO15 RX), 3.3V.

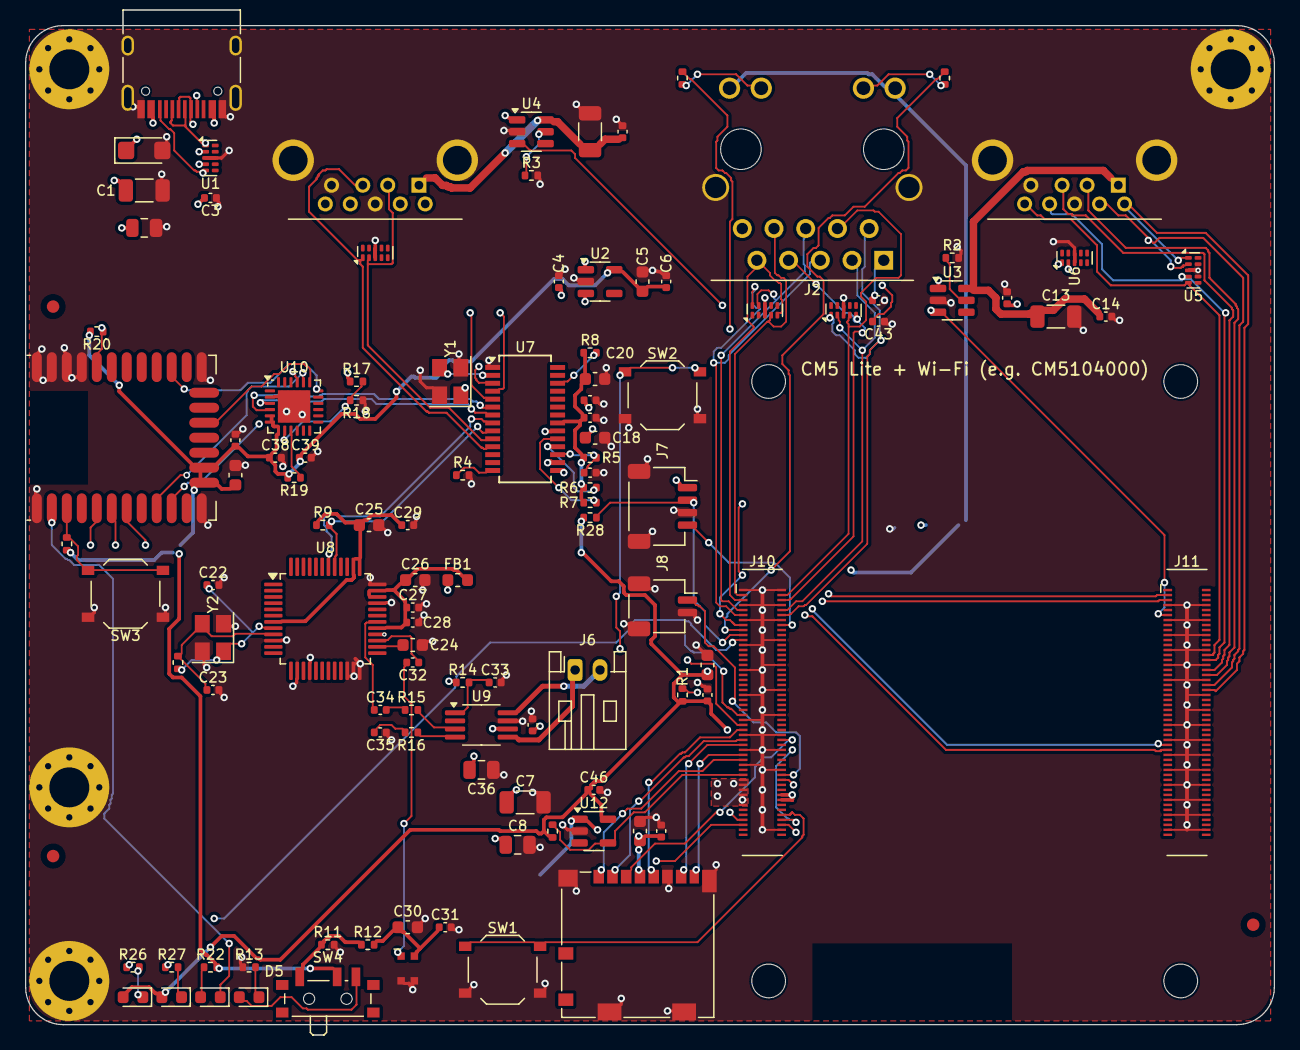
[picture p24: board hvh.kicad_pcb from above]

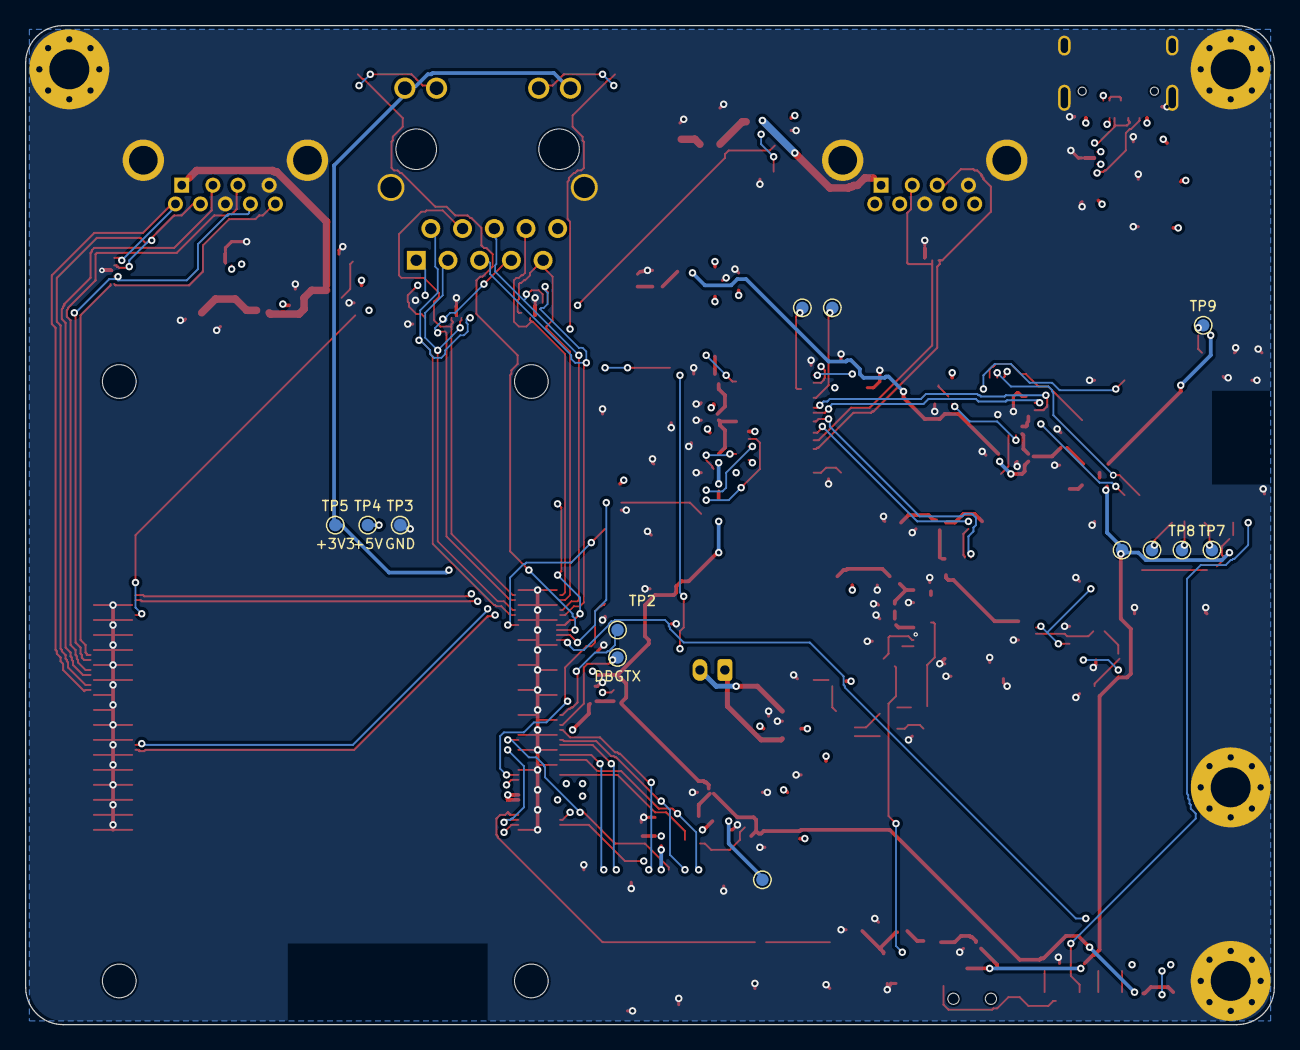
[picture p25: board hvh.kicad_pcb from below]

Board: 6 copper layers, 100.0 x 80.0 mm, 132 parts (13 on the bottom side), 103 nets.
